rFeijoo/FPGA_PID/README.md

# Betta's House
Implementação em FPGA de um sistema de controle PID para controle da temperatura em aquários de pequeno porte, do tipo beteira.
