rFeijoo/FPGA_PID/PC2/2 - octave/Hardware_VS_Software - Integrative Simulation.png

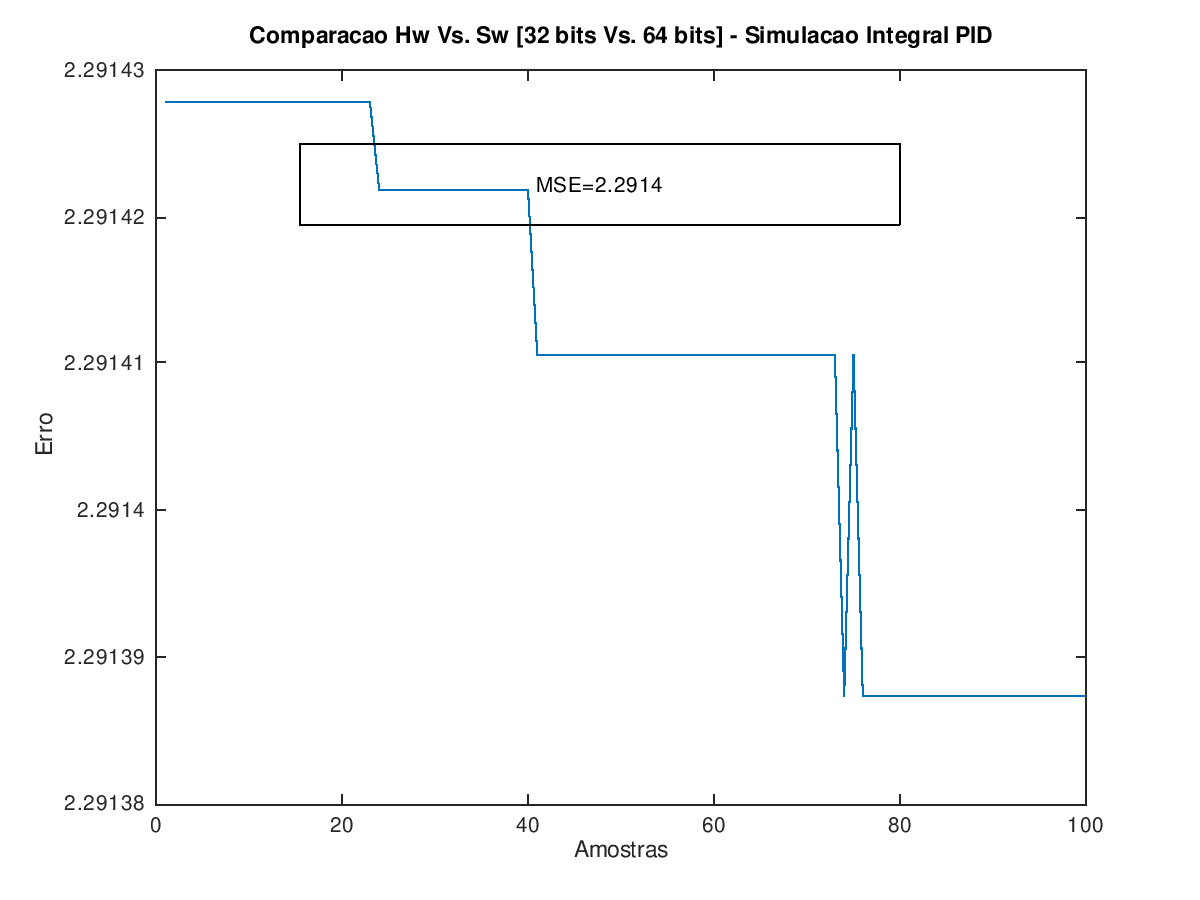
PC2/2 - octave/Hardware_VS_Software - Integrative Simulation.png
