rFeijoo/FPGA_PID/PC3/3 - Interface - Arduino X Basys3/1 - Esquemático RTL.png

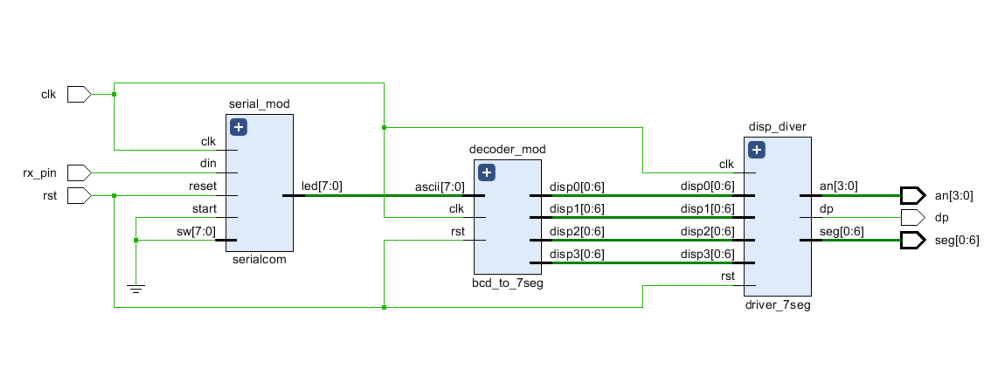
PC3/3 - Interface - Arduino X Basys3/1 - Esquemático RTL.png
