rFeijoo/FPGA_PID/PC3/3 - Interface - Arduino X Basys3/2 - Layout.png

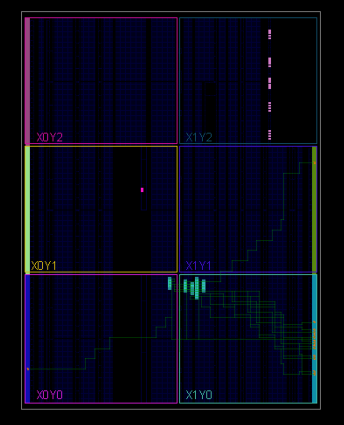
PC3/3 - Interface - Arduino X Basys3/2 - Layout.png
