rFeijoo/FPGA_PID/PC3/3 - Interface - Arduino X Basys3/3 - Consumo de Potência.png

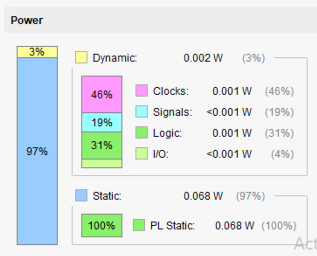
PC3/3 - Interface - Arduino X Basys3/3 - Consumo de Potência.png
