rFeijoo/FPGA_PID/PC3/3 - Interface - Arduino X Basys3/4 - Gráfico de Potência.png

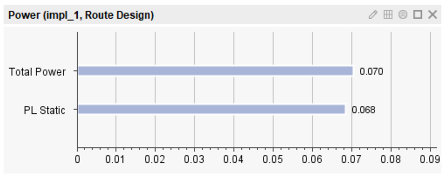
PC3/3 - Interface - Arduino X Basys3/4 - Gráfico de Potência.png
