rFeijoo/FPGA_PID/PC3/5 - Figuras/Figura 3.png

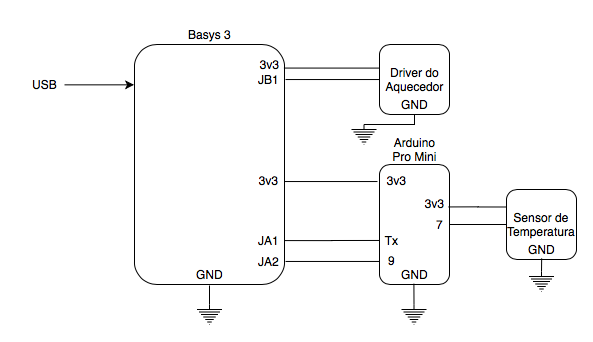
PC3/5 - Figuras/Figura 3.png
