rFeijoo/FPGA_PID/PC3/5 - Figuras/Figura 4.png

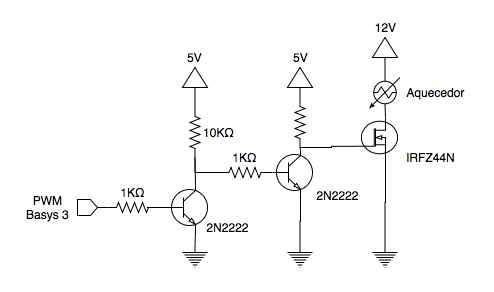
PC3/5 - Figuras/Figura 4.png
