rFeijoo/FPGA_PID/PC3/5 - Figuras/Figura 5.png

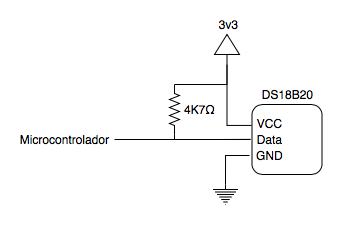
PC3/5 - Figuras/Figura 5.png
