rFeijoo/FPGA_PID/PC3/5 - Figuras/Figura 7.png

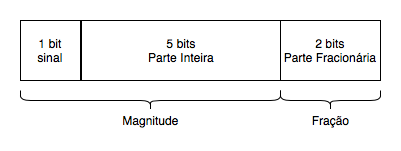
PC3/5 - Figuras/Figura 7.png
