rFeijoo/FPGA_PID/PC3/5 - Figuras/Figura 9.png

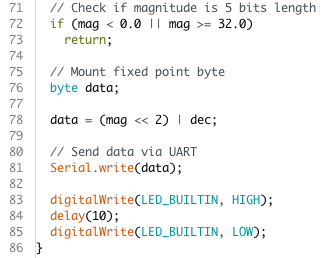
PC3/5 - Figuras/Figura 9.png
