rFeijoo/FPGA_PID/PC3/5 - Figuras/Figura 12.png

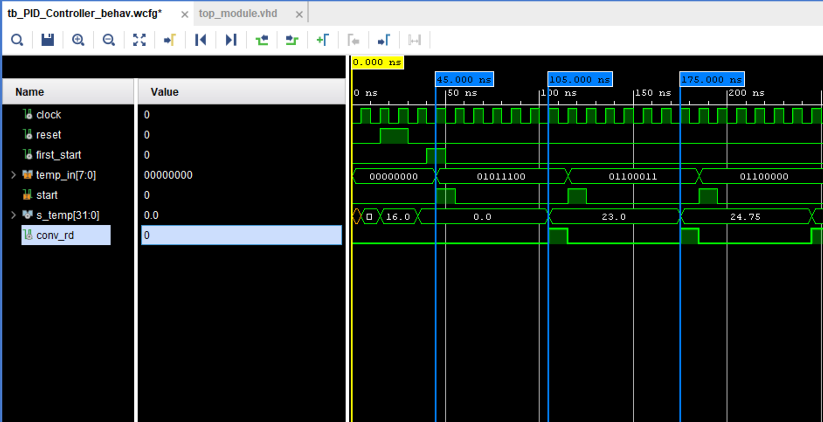
PC3/5 - Figuras/Figura 12.png
