rFeijoo/FPGA_PID/PC3/5 - Figuras/Figura 13.png

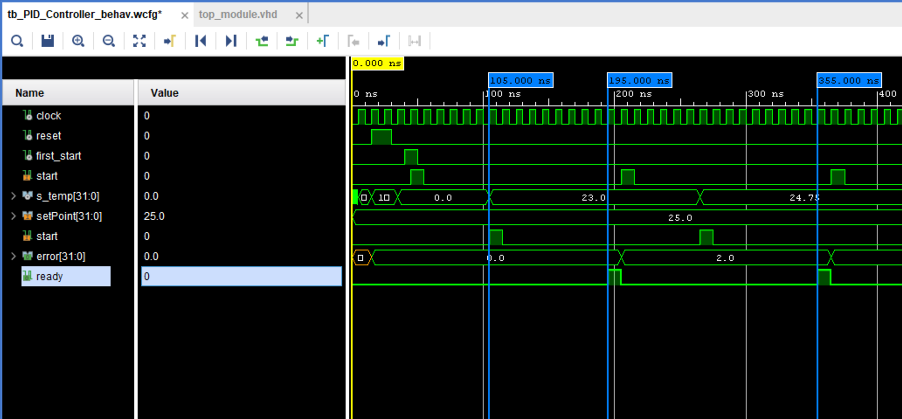
PC3/5 - Figuras/Figura 13.png
