rFeijoo/FPGA_PID/PC3/5 - Figuras/Figura 15.png

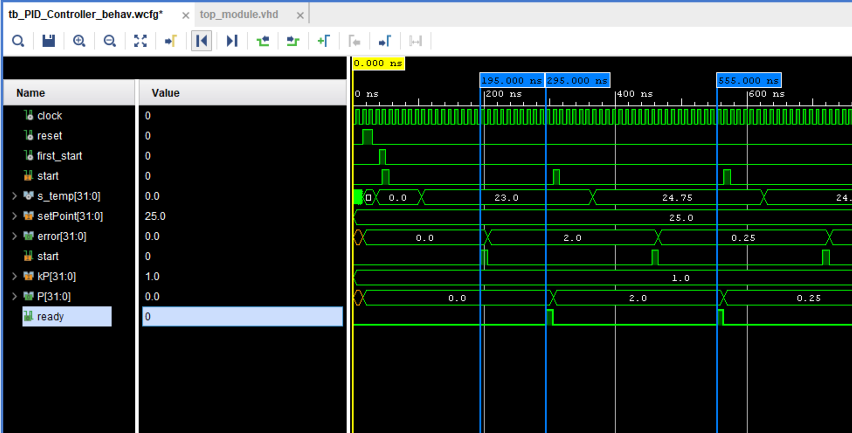
PC3/5 - Figuras/Figura 15.png
