rFeijoo/FPGA_PID/PC3/5 - Figuras/Figura 17.png

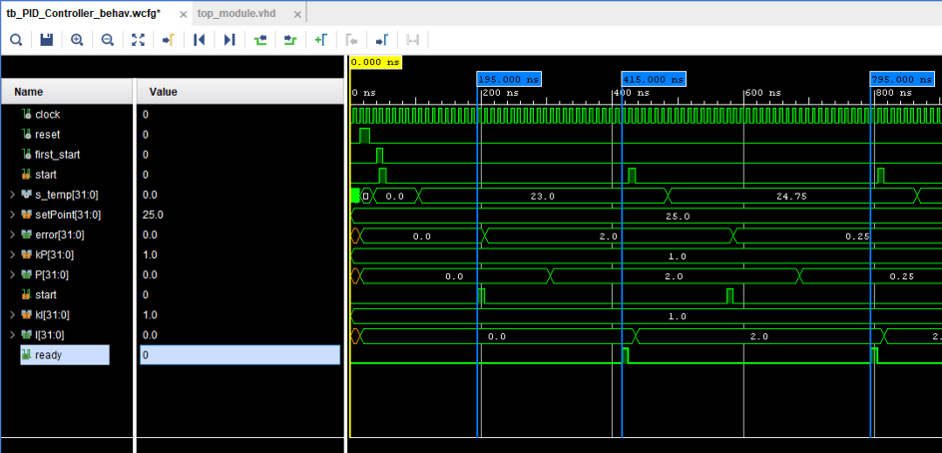
PC3/5 - Figuras/Figura 17.png
