rFeijoo/FPGA_PID/PC3/5 - Figuras/Figura 19.png

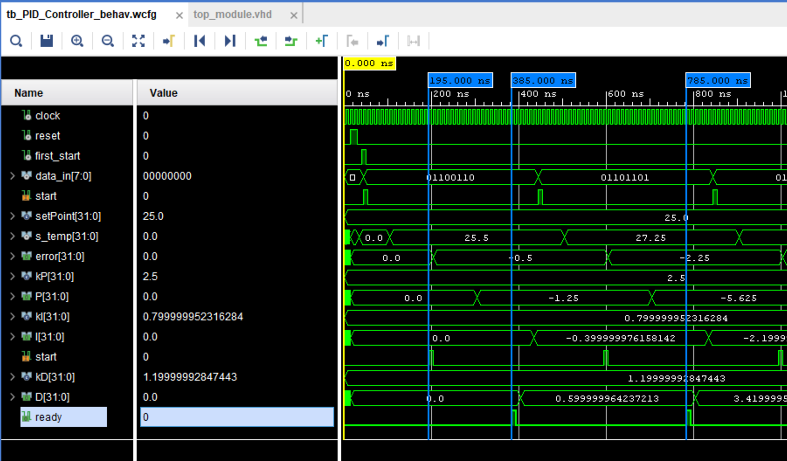
PC3/5 - Figuras/Figura 19.png
