rFeijoo/FPGA_PID/PC3/5 - Figuras/Figura 21.png

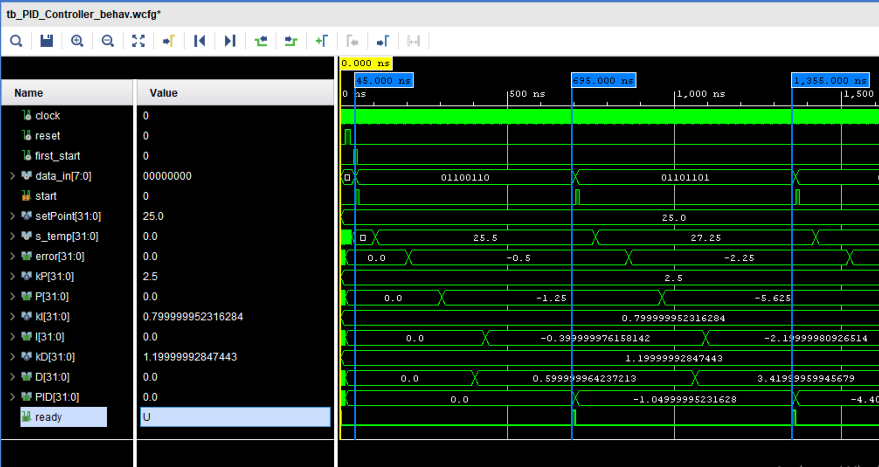
PC3/5 - Figuras/Figura 21.png
