rFeijoo/FPGA_PID/PC4/5 - Figuras/Figura 23.png

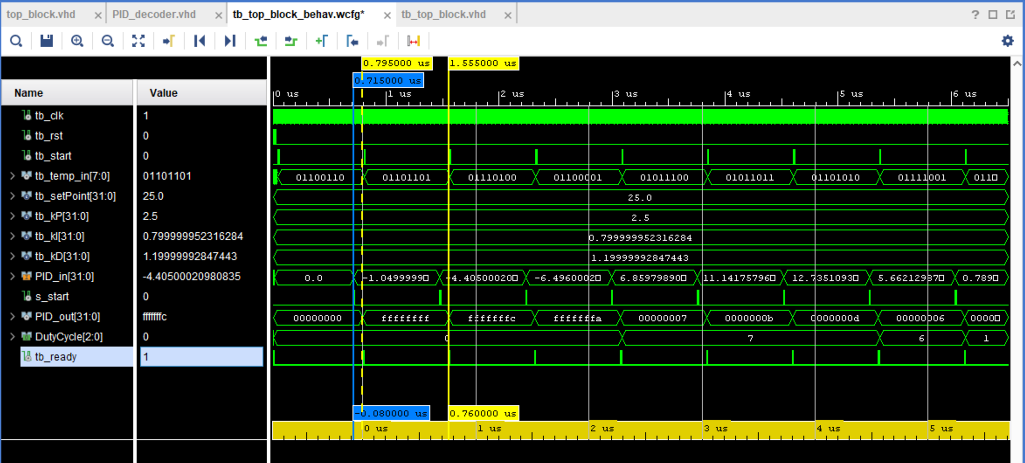
PC4/5 - Figuras/Figura 23.png
