rFeijoo/FPGA_PID/PC4/5 - Figuras/Figura 25.png

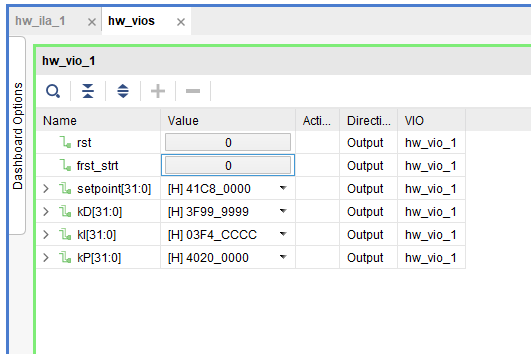
PC4/5 - Figuras/Figura 25.png
