rFeijoo/FPGA_PID/PC4/5 - Figuras/Figura 26.png

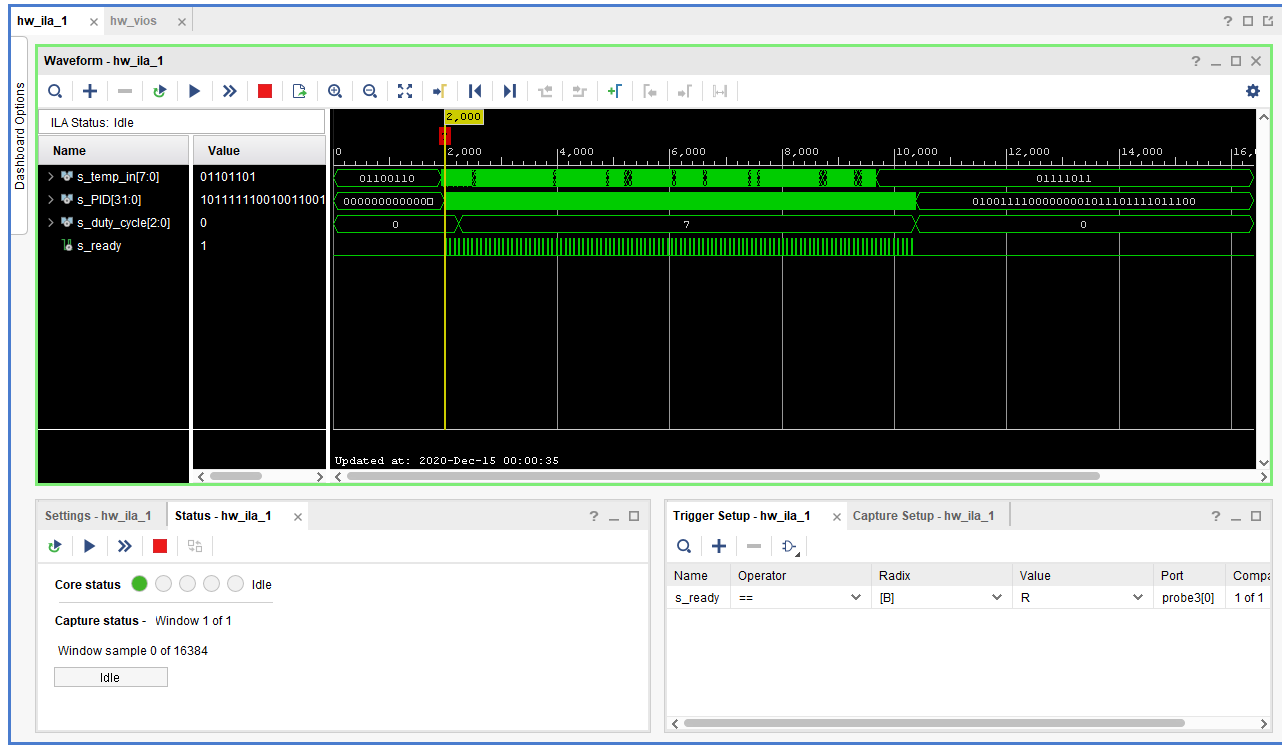
PC4/5 - Figuras/Figura 26.png
