rFeijoo/FPGA_PID/PC4/5 - Figuras/Figura 27.png

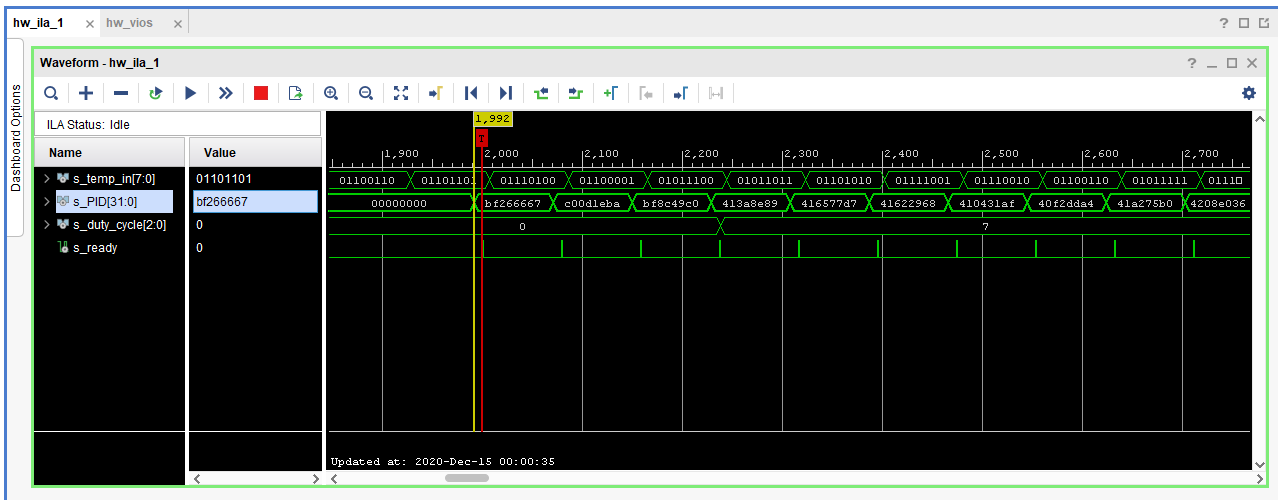
PC4/5 - Figuras/Figura 27.png
