rFeijoo/FPGA_PID/PC4/5 - Figuras/Figura 28.png

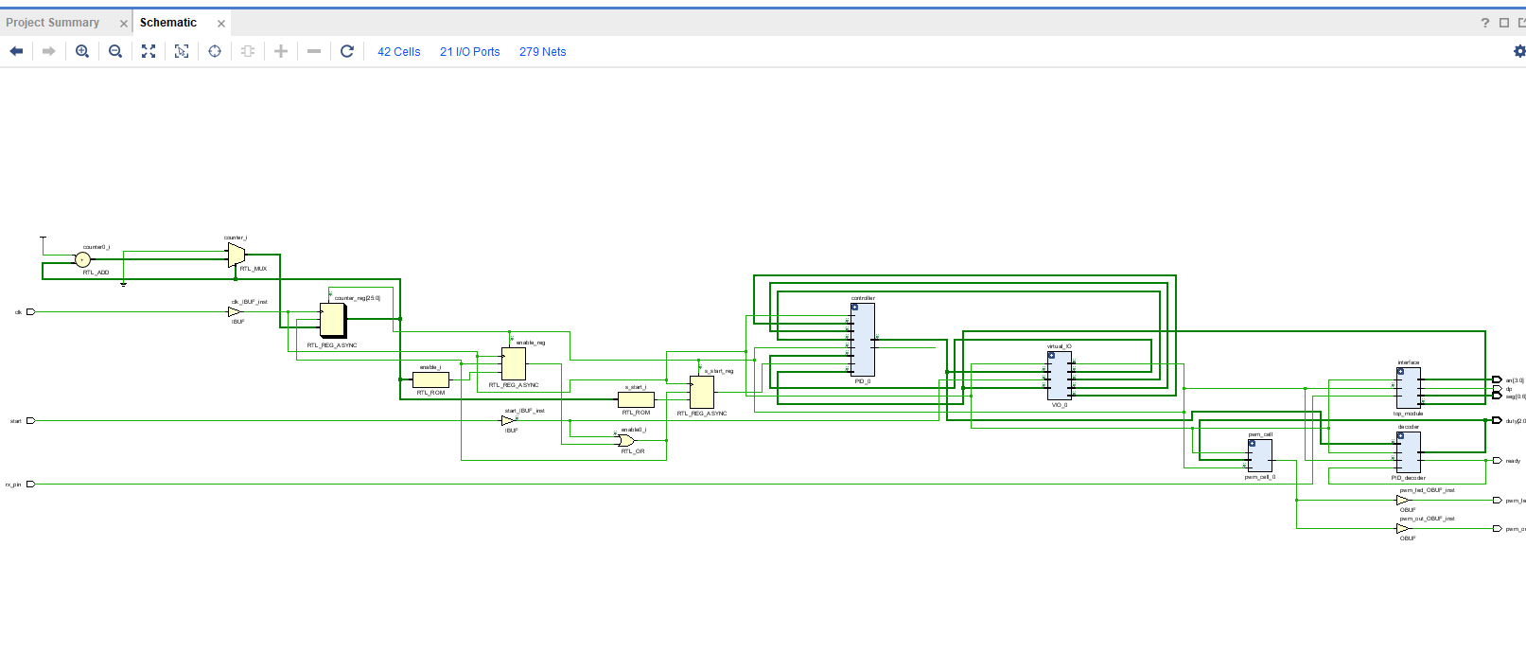
PC4/5 - Figuras/Figura 28.png
