rFeijoo/FPGA_PID/PC4/5 - Figuras/Figura 29.png

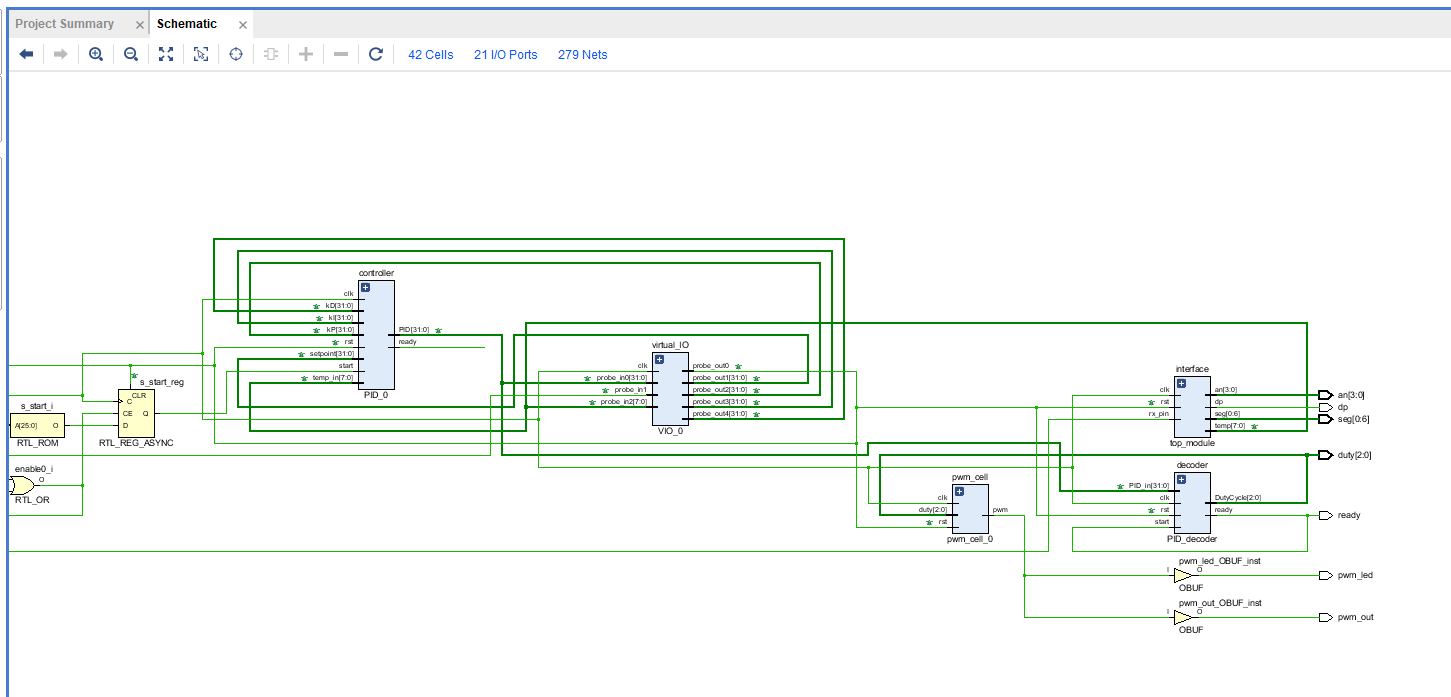
PC4/5 - Figuras/Figura 29.png
