rFeijoo/FPGA_PID/PC4/5 - Figuras/Figura 30.png

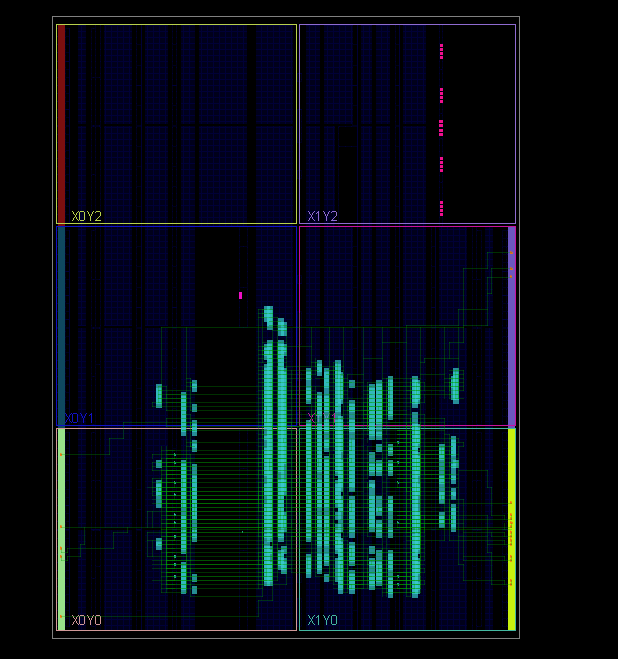
PC4/5 - Figuras/Figura 30.png
