rFeijoo/FPGA_PID/PC4/5 - Figuras/Figura 32.png

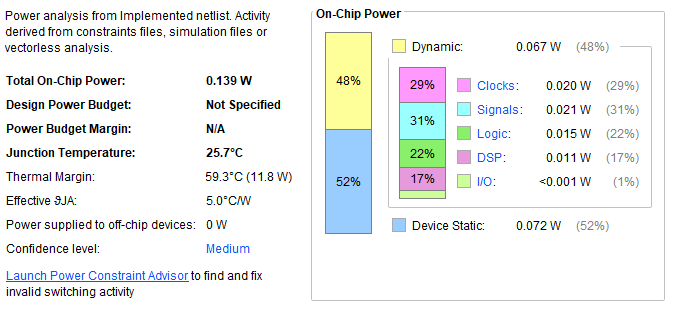
PC4/5 - Figuras/Figura 32.png
