rFeijoo/FPGA_PID/PC4/6 - vivado/Interface_Arduino_Basys3.srcs/sources_1/ip/PID_0/synth/PID_0.vhd

-- (c) Copyright 1995-2020 Xilinx, Inc. All rights reserved.
-- 
-- This file contains confidential and proprietary information
-- of Xilinx, Inc. and is protected under U.S. and
-- international copyright and other intellectual property
-- laws.
-- 
-- DISCLAIMER
-- This disclaimer is not a license and does not grant any
-- rights to the materials distributed herewith. Except as
-- otherwise provided in a valid license issued to you by
-- Xilinx, and to the maximum extent permitted by applicable
-- law: (1) THESE MATERIALS ARE MADE AVAILABLE "AS IS" AND
-- WITH ALL FAULTS, AND XILINX HEREBY DISCLAIMS ALL WARRANTIES
-- AND CONDITIONS, EXPRESS, IMPLIED, OR STATUTORY, INCLUDING
-- BUT NOT LIMITED TO WARRANTIES OF MERCHANTABILITY, NON-
-- INFRINGEMENT, OR FITNESS FOR ANY PARTICULAR PURPOSE; and
-- (2) Xilinx shall not be liable (whether in contract or tort,
-- including negligence, or under any other theory of
-- liability) for any loss or damage of any kind or nature
-- related to, arising under or in connection with these
-- materials, including for any direct, or any indirect,
-- special, incidental, or consequential loss or damage
-- (including loss of data, profits, goodwill, or any type of
-- loss or damage suffered as a result of any action brought
-- by a third party) even if such damage or loss was
-- reasonably foreseeable or Xilinx had been advised of the
-- possibility of the same.
-- 
-- CRITICAL APPLICATIONS
-- Xilinx products are not designed or intended to be fail-
-- safe, or for use in any application requiring fail-safe
-- performance, such as life-support or safety devices or
-- systems, Class III medical devices, nuclear facilities,
-- applications related to the deployment of airbags, or any
-- other applications that could lead to death, personal
-- injury, or severe property or environmental damage
-- (individually and collectively, "Critical
-- Applications"). Customer assumes the sole risk and
-- liability of any use of Xilinx products in Critical
-- Applications, subject only to applicable laws and
-- regulations governing limitations on product liability.
-- 
-- THIS COPYRIGHT NOTICE AND DISCLAIMER MUST BE RETAINED AS
-- PART OF THIS FILE AT ALL TIMES.
-- 
-- DO NOT MODIFY THIS FILE.

-- IP VLNV: xilinx.com:user:PID:1.0
-- IP Revision: 1

LIBRARY ieee;
USE ieee.std_logic_1164.ALL;
USE ieee.numeric_std.ALL;

ENTITY PID_0 IS
  PORT (
    clk : IN STD_LOGIC;
    rst : IN STD_LOGIC;
    start : IN STD_LOGIC;
    temp_in : IN STD_LOGIC_VECTOR(7 DOWNTO 0);
    setpoint : IN STD_LOGIC_VECTOR(31 DOWNTO 0);
    kP : IN STD_LOGIC_VECTOR(31 DOWNTO 0);
    kI : IN STD_LOGIC_VECTOR(31 DOWNTO 0);
    kD : IN STD_LOGIC_VECTOR(31 DOWNTO 0);
    PID : OUT STD_LOGIC_VECTOR(31 DOWNTO 0);
    ready : OUT STD_LOGIC
  );
END PID_0;

ARCHITECTURE PID_0_arch OF PID_0 IS
  ATTRIBUTE DowngradeIPIdentifiedWarnings : STRING;
  ATTRIBUTE DowngradeIPIdentifiedWarnings OF PID_0_arch: ARCHITECTURE IS "yes";
  COMPONENT top_module IS
    PORT (
      clk : IN STD_LOGIC;
      rst : IN STD_LOGIC;
      start : IN STD_LOGIC;
      temp_in : IN STD_LOGIC_VECTOR(7 DOWNTO 0);
      setpoint : IN STD_LOGIC_VECTOR(31 DOWNTO 0);
      kP : IN STD_LOGIC_VECTOR(31 DOWNTO 0);
      kI : IN STD_LOGIC_VECTOR(31 DOWNTO 0);
      kD : IN STD_LOGIC_VECTOR(31 DOWNTO 0);
      PID : OUT STD_LOGIC_VECTOR(31 DOWNTO 0);
      ready : OUT STD_LOGIC
    );
  END COMPONENT top_module;
  ATTRIBUTE X_CORE_INFO : STRING;
  ATTRIBUTE X_CORE_INFO OF PID_0_arch: ARCHITECTURE IS "top_module,Vivado 2018.3";
  ATTRIBUTE CHECK_LICENSE_TYPE : STRING;
  ATTRIBUTE CHECK_LICENSE_TYPE OF PID_0_arch : ARCHITECTURE IS "PID_0,top_module,{}";
  ATTRIBUTE CORE_GENERATION_INFO : STRING;
  ATTRIBUTE CORE_GENERATION_INFO OF PID_0_arch: ARCHITECTURE IS "PID_0,top_module,{x_ipProduct=Vivado 2018.3,x_ipVendor=xilinx.com,x_ipLibrary=user,x_ipName=PID,x_ipVersion=1.0,x_ipCoreRevision=1,x_ipLanguage=VHDL,x_ipSimLanguage=MIXED}";
  ATTRIBUTE IP_DEFINITION_SOURCE : STRING;
  ATTRIBUTE IP_DEFINITION_SOURCE OF PID_0_arch: ARCHITECTURE IS "package_project";
  ATTRIBUTE X_INTERFACE_INFO : STRING;
  ATTRIBUTE X_INTERFACE_PARAMETER : STRING;
  ATTRIBUTE X_INTERFACE_PARAMETER OF rst: SIGNAL IS "XIL_INTERFACENAME rst, POLARITY ACTIVE_LOW, INSERT_VIP 0";
  ATTRIBUTE X_INTERFACE_INFO OF rst: SIGNAL IS "xilinx.com:signal:reset:1.0 rst RST";
  ATTRIBUTE X_INTERFACE_PARAMETER OF clk: SIGNAL IS "XIL_INTERFACENAME clk, ASSOCIATED_RESET rst, FREQ_HZ 100000000, PHASE 0.000, INSERT_VIP 0";
  ATTRIBUTE X_INTERFACE_INFO OF clk: SIGNAL IS "xilinx.com:signal:clock:1.0 clk CLK";
BEGIN
  U0 : top_module
    PORT MAP (
      clk => clk,
      rst => rst,
      start => start,
      temp_in => temp_in,
      setpoint => setpoint,
      kP => kP,
      kI => kI,
      kD => kD,
      PID => PID,
      ready => ready
    );
END PID_0_arch;
