rFeijoo/FPGA_PID/PC4/6 - vivado/Interface_Arduino_Basys3.srcs/sources_1/ip/VIO_0/VIO_0_stub.vhdl

-- Copyright 1986-2018 Xilinx, Inc. All Rights Reserved.
-- --------------------------------------------------------------------------------
-- Tool Version: Vivado v.2018.3 (win64) Build 2405991 Thu Dec  6 23:38:27 MST 2018
-- Date        : Tue Dec 15 05:30:55 2020
-- Host        : RAFAELFEIJL2C3E running 64-bit major release  (build 9200)
-- Command     : write_vhdl -force -mode synth_stub
--               C:/Mac/Home/Documents/Windows/Vivado/Projects/Interface_Arduino_Basys3/Interface_Arduino_Basys3.srcs/sources_1/ip/VIO_0/VIO_0_stub.vhdl
-- Design      : VIO_0
-- Purpose     : Stub declaration of top-level module interface
-- Device      : xc7a35tcpg236-1
-- --------------------------------------------------------------------------------
library IEEE;
use IEEE.STD_LOGIC_1164.ALL;

entity VIO_0 is
  Port ( 
    clk : in STD_LOGIC;
    probe_in0 : in STD_LOGIC_VECTOR ( 31 downto 0 );
    probe_in1 : in STD_LOGIC_VECTOR ( 0 to 0 );
    probe_in2 : in STD_LOGIC_VECTOR ( 7 downto 0 );
    probe_out0 : out STD_LOGIC_VECTOR ( 0 to 0 );
    probe_out1 : out STD_LOGIC_VECTOR ( 31 downto 0 );
    probe_out2 : out STD_LOGIC_VECTOR ( 31 downto 0 );
    probe_out3 : out STD_LOGIC_VECTOR ( 31 downto 0 );
    probe_out4 : out STD_LOGIC_VECTOR ( 31 downto 0 )
  );

end VIO_0;

architecture stub of VIO_0 is
attribute syn_black_box : boolean;
attribute black_box_pad_pin : string;
attribute syn_black_box of stub : architecture is true;
attribute black_box_pad_pin of stub : architecture is "clk,probe_in0[31:0],probe_in1[0:0],probe_in2[7:0],probe_out0[0:0],probe_out1[31:0],probe_out2[31:0],probe_out3[31:0],probe_out4[31:0]";
attribute X_CORE_INFO : string;
attribute X_CORE_INFO of stub : architecture is "vio,Vivado 2018.3";
begin
end;
