rFeijoo/FPGA_PID/PC4/6 - vivado/Interface_Arduino_Basys3.srcs/sources_1/ip/pwm_cell_0/pwm_cell_0_sim_netlist.v

// Copyright 1986-2018 Xilinx, Inc. All Rights Reserved.
// --------------------------------------------------------------------------------
// Tool Version: Vivado v.2018.3 (win64) Build 2405991 Thu Dec  6 23:38:27 MST 2018
// Date        : Tue Dec 15 06:12:34 2020
// Host        : RAFAELFEIJL2C3E running 64-bit major release  (build 9200)
// Command     : write_verilog -force -mode funcsim
//               c:/Mac/Home/Documents/Windows/Vivado/Projects/Interface_Arduino_Basys3/Interface_Arduino_Basys3.srcs/sources_1/ip/pwm_cell_0/pwm_cell_0_sim_netlist.v
// Design      : pwm_cell_0
// Purpose     : This verilog netlist is a functional simulation representation of the design and should not be modified
//               or synthesized. This netlist cannot be used for SDF annotated simulation.
// Device      : xc7a35tcpg236-1
// --------------------------------------------------------------------------------
`timescale 1 ps / 1 ps

(* CHECK_LICENSE_TYPE = "pwm_cell_0,pwm_cell,{}" *) (* downgradeipidentifiedwarnings = "yes" *) (* ip_definition_source = "package_project" *) 
(* x_core_info = "pwm_cell,Vivado 2018.3" *) 
(* NotValidForBitStream *)
module pwm_cell_0
   (clk,
    rst,
    duty,
    pwm);
  (* x_interface_info = "xilinx.com:signal:clock:1.0 clk CLK" *) (* x_interface_parameter = "XIL_INTERFACENAME clk, ASSOCIATED_RESET rst, FREQ_HZ 100000000, PHASE 0.000, INSERT_VIP 0" *) input clk;
  (* x_interface_info = "xilinx.com:signal:reset:1.0 rst RST" *) (* x_interface_parameter = "XIL_INTERFACENAME rst, POLARITY ACTIVE_LOW, INSERT_VIP 0" *) input rst;
  input [2:0]duty;
  output pwm;

  wire clk;
  wire [2:0]duty;
  wire pwm;
  wire rst;

  pwm_cell_0_pwm_cell U0
       (.clk(clk),
        .duty(duty),
        .pwm(pwm),
        .rst(rst));
endmodule

(* ORIG_REF_NAME = "pwm_cell" *) 
module pwm_cell_0_pwm_cell
   (pwm,
    clk,
    duty,
    rst);
  output pwm;
  input clk;
  input [2:0]duty;
  input rst;

  wire clk;
  wire [31:1]data0;
  wire [2:0]duty;
  wire pwm;
  wire rst;
  wire [31:0]s_clk_counter;
  wire [31:0]s_clk_counter_0;
  wire \s_clk_counter_reg[12]_i_2_n_0 ;
  wire \s_clk_counter_reg[12]_i_2_n_1 ;
  wire \s_clk_counter_reg[12]_i_2_n_2 ;
  wire \s_clk_counter_reg[12]_i_2_n_3 ;
  wire \s_clk_counter_reg[16]_i_2_n_0 ;
  wire \s_clk_counter_reg[16]_i_2_n_1 ;
  wire \s_clk_counter_reg[16]_i_2_n_2 ;
  wire \s_clk_counter_reg[16]_i_2_n_3 ;
  wire \s_clk_counter_reg[20]_i_2_n_0 ;
  wire \s_clk_counter_reg[20]_i_2_n_1 ;
  wire \s_clk_counter_reg[20]_i_2_n_2 ;
  wire \s_clk_counter_reg[20]_i_2_n_3 ;
  wire \s_clk_counter_reg[24]_i_2_n_0 ;
  wire \s_clk_counter_reg[24]_i_2_n_1 ;
  wire \s_clk_counter_reg[24]_i_2_n_2 ;
  wire \s_clk_counter_reg[24]_i_2_n_3 ;
  wire \s_clk_counter_reg[28]_i_2_n_0 ;
  wire \s_clk_counter_reg[28]_i_2_n_1 ;
  wire \s_clk_counter_reg[28]_i_2_n_2 ;
  wire \s_clk_counter_reg[28]_i_2_n_3 ;
  wire \s_clk_counter_reg[31]_i_2_n_2 ;
  wire \s_clk_counter_reg[31]_i_2_n_3 ;
  wire \s_clk_counter_reg[4]_i_2_n_0 ;
  wire \s_clk_counter_reg[4]_i_2_n_1 ;
  wire \s_clk_counter_reg[4]_i_2_n_2 ;
  wire \s_clk_counter_reg[4]_i_2_n_3 ;
  wire \s_clk_counter_reg[8]_i_2_n_0 ;
  wire \s_clk_counter_reg[8]_i_2_n_1 ;
  wire \s_clk_counter_reg[8]_i_2_n_2 ;
  wire \s_clk_counter_reg[8]_i_2_n_3 ;
  wire s_pwm0_carry__0_n_0;
  wire s_pwm0_carry__0_n_1;
  wire s_pwm0_carry__0_n_2;
  wire s_pwm0_carry__0_n_3;
  wire s_pwm0_carry__1_n_1;
  wire s_pwm0_carry__1_n_2;
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
  LUT6 #(
    .INIT(64'h2010020401024001)) 
    s_pwm0_carry_i_4
       (.I0(s_clk_counter[13]),
        .I1(s_clk_counter[14]),
        .I2(s_clk_counter[12]),
        .I3(duty[2]),
        .I4(duty[1]),
        .I5(duty[0]),
        .O(s_pwm0_carry_i_4_n_0));
  LUT6 #(
    .INIT(64'h2400201000820201)) 
    s_pwm0_carry_i_4__0
       (.I0(s_clk_counter[2]),
        .I1(s_clk_counter[1]),
        .I2(duty[2]),
        .I3(duty[0]),
        .I4(duty[1]),
        .I5(s_clk_counter[0]),
        .O(s_pwm0_carry_i_4__0_n_0));
  (* SOFT_HLUTNM = "soft_lutpair0" *) 
  LUT3 #(
    .INIT(8'h73)) 
    s_pwm_i_1
       (.I0(s_pwm0_carry__1_n_1),
        .I1(s_pwm_i_3_n_0),
        .I2(pwm),
        .O(s_pwm_i_1_n_0));
  LUT4 #(
    .INIT(16'hFF01)) 
    s_pwm_i_2
       (.I0(duty[2]),
        .I1(duty[0]),
        .I2(duty[1]),
        .I3(rst),
        .O(s_pwm_i_2_n_0));
  LUT6 #(
    .INIT(64'hFFFFFFFFFFFFFFFE)) 
    s_pwm_i_3
       (.I0(s_pwm_i_4_n_0),
        .I1(s_pwm_i_5_n_0),
        .I2(s_pwm_i_6_n_0),
        .I3(s_pwm_i_7_n_0),
        .I4(s_pwm_i_8_n_0),
        .I5(s_pwm_i_9_n_0),
        .O(s_pwm_i_3_n_0));
  LUT5 #(
    .INIT(32'hFFFFFFFE)) 
    s_pwm_i_4
       (.I0(s_clk_counter[27]),
        .I1(s_clk_counter[28]),
        .I2(s_clk_counter[29]),
        .I3(s_clk_counter[31]),
        .I4(s_clk_counter[30]),
        .O(s_pwm_i_4_n_0));
  (* SOFT_HLUTNM = "soft_lutpair1" *) 
  LUT3 #(
    .INIT(8'hDF)) 
    s_pwm_i_5
       (.I0(s_clk_counter[2]),
        .I1(s_clk_counter[1]),
        .I2(s_clk_counter[0]),
        .O(s_pwm_i_5_n_0));
  LUT6 #(
    .INIT(64'hFFFFFDFFFFFFFFFF)) 
    s_pwm_i_6
       (.I0(s_clk_counter[15]),
        .I1(s_clk_counter[16]),
        .I2(s_clk_counter[17]),
        .I3(s_clk_counter[19]),
        .I4(s_clk_counter[20]),
        .I5(s_clk_counter[18]),
        .O(s_pwm_i_6_n_0));
  LUT6 #(
    .INIT(64'hFFFFFFFFFFFFFFFE)) 
    s_pwm_i_7
       (.I0(s_clk_counter[21]),
        .I1(s_clk_counter[22]),
        .I2(s_clk_counter[23]),
        .I3(s_clk_counter[24]),
        .I4(s_clk_counter[25]),
        .I5(s_clk_counter[26]),
        .O(s_pwm_i_7_n_0));
  LUT6 #(
    .INIT(64'hFFFFDFFFFFFFFFFF)) 
    s_pwm_i_8
       (.I0(s_clk_counter[9]),
        .I1(s_clk_counter[11]),
        .I2(s_clk_counter[10]),
        .I3(s_clk_counter[12]),
        .I4(s_clk_counter[14]),
        .I5(s_clk_counter[13]),
        .O(s_pwm_i_8_n_0));
  LUT6 #(
    .INIT(64'hFFFFFFDFFFFFFFFF)) 
    s_pwm_i_9
       (.I0(s_clk_counter[4]),
        .I1(s_clk_counter[3]),
        .I2(s_clk_counter[5]),
        .I3(s_clk_counter[7]),
        .I4(s_clk_counter[6]),
        .I5(s_clk_counter[8]),
        .O(s_pwm_i_9_n_0));
  FDCE #(
    .INIT(1'b0)) 
    s_pwm_reg
       (.C(clk),
        .CE(1'b1),
        .CLR(s_pwm_i_2_n_0),
        .D(s_pwm_i_1_n_0),
        .Q(pwm));
endmodule
`ifndef GLBL
`define GLBL
`timescale  1 ps / 1 ps

module glbl ();

    parameter ROC_WIDTH = 100000;
    parameter TOC_WIDTH = 0;

//--------   STARTUP Globals --------------
    wire GSR;
    wire GTS;
    wire GWE;
    wire PRLD;
    tri1 p_up_tmp;
    tri (weak1, strong0) PLL_LOCKG = p_up_tmp;

    wire PROGB_GLBL;
    wire CCLKO_GLBL;
    wire FCSBO_GLBL;
    wire [3:0] DO_GLBL;
    wire [3:0] DI_GLBL;
   
    reg GSR_int;
    reg GTS_int;
    reg PRLD_int;

//--------   JTAG Globals --------------
    wire JTAG_TDO_GLBL;
    wire JTAG_TCK_GLBL;
    wire JTAG_TDI_GLBL;
    wire JTAG_TMS_GLBL;
    wire JTAG_TRST_GLBL;

    reg JTAG_CAPTURE_GLBL;
    reg JTAG_RESET_GLBL;
    reg JTAG_SHIFT_GLBL;
    reg JTAG_UPDATE_GLBL;
    reg JTAG_RUNTEST_GLBL;

    reg JTAG_SEL1_GLBL = 0;
    reg JTAG_SEL2_GLBL = 0 ;
    reg JTAG_SEL3_GLBL = 0;
    reg JTAG_SEL4_GLBL = 0;

    reg JTAG_USER_TDO1_GLBL = 1'bz;
    reg JTAG_USER_TDO2_GLBL = 1'bz;
    reg JTAG_USER_TDO3_GLBL = 1'bz;
    reg JTAG_USER_TDO4_GLBL = 1'bz;

    assign (strong1, weak0) GSR = GSR_int;
    assign (strong1, weak0) GTS = GTS_int;
    assign (weak1, weak0) PRLD = PRLD_int;

    initial begin
	GSR_int = 1'b1;
	PRLD_int = 1'b1;
	#(ROC_WIDTH)
	GSR_int = 1'b0;
	PRLD_int = 1'b0;
    end

    initial begin
	GTS_int = 1'b1;
	#(TOC_WIDTH)
	GTS_int = 1'b0;
    end

endmodule
`endif
