rFeijoo/FPGA_PID/PC4/6 - vivado/Interface_Arduino_Basys3.srcs/sources_1/ip/pwm_cell_0/pwm_cell_0_sim_netlist.vhdl

-- Copyright 1986-2018 Xilinx, Inc. All Rights Reserved.
-- --------------------------------------------------------------------------------
-- Tool Version: Vivado v.2018.3 (win64) Build 2405991 Thu Dec  6 23:38:27 MST 2018
-- Date        : Tue Dec 15 06:12:34 2020
-- Host        : RAFAELFEIJL2C3E running 64-bit major release  (build 9200)
-- Command     : write_vhdl -force -mode funcsim
--               c:/Mac/Home/Documents/Windows/Vivado/Projects/Interface_Arduino_Basys3/Interface_Arduino_Basys3.srcs/sources_1/ip/pwm_cell_0/pwm_cell_0_sim_netlist.vhdl
-- Design      : pwm_cell_0
-- Purpose     : This VHDL netlist is a functional simulation representation of the design and should not be modified or
--               synthesized. This netlist cannot be used for SDF annotated simulation.
-- Device      : xc7a35tcpg236-1
-- --------------------------------------------------------------------------------
library IEEE;
use IEEE.STD_LOGIC_1164.ALL;
library UNISIM;
use UNISIM.VCOMPONENTS.ALL;
entity pwm_cell_0_pwm_cell is
  port (
    pwm : out STD_LOGIC;
    clk : in STD_LOGIC;
    duty : in STD_LOGIC_VECTOR ( 2 downto 0 );
    rst : in STD_LOGIC
  );
  attribute ORIG_REF_NAME : string;
  attribute ORIG_REF_NAME of pwm_cell_0_pwm_cell : entity is "pwm_cell";
end pwm_cell_0_pwm_cell;

architecture STRUCTURE of pwm_cell_0_pwm_cell is
  signal data0 : STD_LOGIC_VECTOR ( 31 downto 1 );
  signal \^pwm\ : STD_LOGIC;
  signal s_clk_counter : STD_LOGIC_VECTOR ( 31 downto 0 );
  signal s_clk_counter_0 : STD_LOGIC_VECTOR ( 31 downto 0 );
  signal \s_clk_counter_reg[12]_i_2_n_0\ : STD_LOGIC;
  signal \s_clk_counter_reg[12]_i_2_n_1\ : STD_LOGIC;
  signal \s_clk_counter_reg[12]_i_2_n_2\ : STD_LOGIC;
  signal \s_clk_counter_reg[12]_i_2_n_3\ : STD_LOGIC;
  signal \s_clk_counter_reg[16]_i_2_n_0\ : STD_LOGIC;
  signal \s_clk_counter_reg[16]_i_2_n_1\ : STD_LOGIC;
  signal \s_clk_counter_reg[16]_i_2_n_2\ : STD_LOGIC;
  signal \s_clk_counter_reg[16]_i_2_n_3\ : STD_LOGIC;
  signal \s_clk_counter_reg[20]_i_2_n_0\ : STD_LOGIC;
  signal \s_clk_counter_reg[20]_i_2_n_1\ : STD_LOGIC;
  signal \s_clk_counter_reg[20]_i_2_n_2\ : STD_LOGIC;
  signal \s_clk_counter_reg[20]_i_2_n_3\ : STD_LOGIC;
  signal \s_clk_counter_reg[24]_i_2_n_0\ : STD_LOGIC;
  signal \s_clk_counter_reg[24]_i_2_n_1\ : STD_LOGIC;
  signal \s_clk_counter_reg[24]_i_2_n_2\ : STD_LOGIC;
  signal \s_clk_counter_reg[24]_i_2_n_3\ : STD_LOGIC;
  signal \s_clk_counter_reg[28]_i_2_n_0\ : STD_LOGIC;
  signal \s_clk_counter_reg[28]_i_2_n_1\ : STD_LOGIC;
  signal \s_clk_counter_reg[28]_i_2_n_2\ : STD_LOGIC;
  signal \s_clk_counter_reg[28]_i_2_n_3\ : STD_LOGIC;
  signal \s_clk_counter_reg[31]_i_2_n_2\ : STD_LOGIC;
  signal \s_clk_counter_reg[31]_i_2_n_3\ : STD_LOGIC;
  signal \s_clk_counter_reg[4]_i_2_n_0\ : STD_LOGIC;
  signal \s_clk_counter_reg[4]_i_2_n_1\ : STD_LOGIC;
  signal \s_clk_counter_reg[4]_i_2_n_2\ : STD_LOGIC;
  signal \s_clk_counter_reg[4]_i_2_n_3\ : STD_LOGIC;
  signal \s_clk_counter_reg[8]_i_2_n_0\ : STD_LOGIC;
  signal \s_clk_counter_reg[8]_i_2_n_1\ : STD_LOGIC;
  signal \s_clk_counter_reg[8]_i_2_n_2\ : STD_LOGIC;
  signal \s_clk_counter_reg[8]_i_2_n_3\ : STD_LOGIC;
  signal \s_pwm0_carry__0_n_0\ : STD_LOGIC;
  signal \s_pwm0_carry__0_n_1\ : STD_LOGIC;
  signal \s_pwm0_carry__0_n_2\ : STD_LOGIC;
  signal \s_pwm0_carry__0_n_3\ : STD_LOGIC;
  signal \s_pwm0_carry__1_n_1\ : STD_LOGIC;
  signal \s_pwm0_carry__1_n_2\ : STD_LOGIC;
  signal \s_pwm0_carry__1_n_3\ : STD_LOGIC;
  signal \s_pwm0_carry_i_1__0_n_0\ : STD_LOGIC;
  signal \s_pwm0_carry_i_1__1_n_0\ : STD_LOGIC;
  signal s_pwm0_carry_i_1_n_0 : STD_LOGIC;
  signal \s_pwm0_carry_i_2__0_n_0\ : STD_LOGIC;
  signal \s_pwm0_carry_i_2__1_n_0\ : STD_LOGIC;
  signal s_pwm0_carry_i_2_n_0 : STD_LOGIC;
  signal \s_pwm0_carry_i_3__0_n_0\ : STD_LOGIC;
  signal \s_pwm0_carry_i_3__1_n_0\ : STD_LOGIC;
  signal s_pwm0_carry_i_3_n_0 : STD_LOGIC;
  signal \s_pwm0_carry_i_4__0_n_0\ : STD_LOGIC;
  signal s_pwm0_carry_i_4_n_0 : STD_LOGIC;
  signal s_pwm0_carry_n_0 : STD_LOGIC;
  signal s_pwm0_carry_n_1 : STD_LOGIC;
  signal s_pwm0_carry_n_2 : STD_LOGIC;
  signal s_pwm0_carry_n_3 : STD_LOGIC;
  signal s_pwm_i_1_n_0 : STD_LOGIC;
  signal s_pwm_i_2_n_0 : STD_LOGIC;
  signal s_pwm_i_3_n_0 : STD_LOGIC;
  signal s_pwm_i_4_n_0 : STD_LOGIC;
  signal s_pwm_i_5_n_0 : STD_LOGIC;
  signal s_pwm_i_6_n_0 : STD_LOGIC;
  signal s_pwm_i_7_n_0 : STD_LOGIC;
  signal s_pwm_i_8_n_0 : STD_LOGIC;
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
    generic map(
      INIT => '1'
    )
        port map (
      C => clk,
      CE => '1',
      D => s_clk_counter_0(5),
      PRE => s_pwm_i_2_n_0,
      Q => s_clk_counter(5)
    );
\s_clk_counter_reg[6]\: unisim.vcomponents.FDCE
    generic map(
      INIT => '0'
    )
        port map (
      C => clk,
      CE => '1',
      CLR => s_pwm_i_2_n_0,
      D => s_clk_counter_0(6),
      Q => s_clk_counter(6)
    );
\s_clk_counter_reg[7]\: unisim.vcomponents.FDCE
    generic map(
      INIT => '0'
    )
        port map (
      C => clk,
      CE => '1',
      CLR => s_pwm_i_2_n_0,
      D => s_clk_counter_0(7),
      Q => s_clk_counter(7)
    );
\s_clk_counter_reg[8]\: unisim.vcomponents.FDPE
    generic map(
      INIT => '1'
    )
        port map (
      C => clk,
      CE => '1',
      D => s_clk_counter_0(8),
      PRE => s_pwm_i_2_n_0,
      Q => s_clk_counter(8)
    );
\s_clk_counter_reg[8]_i_2\: unisim.vcomponents.CARRY4
     port map (
      CI => \s_clk_counter_reg[4]_i_2_n_0\,
      CO(3) => \s_clk_counter_reg[8]_i_2_n_0\,
      CO(2) => \s_clk_counter_reg[8]_i_2_n_1\,
      CO(1) => \s_clk_counter_reg[8]_i_2_n_2\,
      CO(0) => \s_clk_counter_reg[8]_i_2_n_3\,
      CYINIT => '0',
      DI(3 downto 0) => B"0000",
      O(3 downto 0) => data0(8 downto 5),
      S(3 downto 0) => s_clk_counter(8 downto 5)
    );
\s_clk_counter_reg[9]\: unisim.vcomponents.FDPE
    generic map(
      INIT => '1'
    )
        port map (
      C => clk,
      CE => '1',
      D => s_clk_counter_0(9),
      PRE => s_pwm_i_2_n_0,
      Q => s_clk_counter(9)
    );
s_pwm0_carry: unisim.vcomponents.CARRY4
     port map (
      CI => '0',
      CO(3) => s_pwm0_carry_n_0,
      CO(2) => s_pwm0_carry_n_1,
      CO(1) => s_pwm0_carry_n_2,
      CO(0) => s_pwm0_carry_n_3,
      CYINIT => '1',
      DI(3 downto 0) => B"0000",
      O(3 downto 0) => NLW_s_pwm0_carry_O_UNCONNECTED(3 downto 0),
      S(3) => s_pwm0_carry_i_1_n_0,
      S(2) => s_pwm0_carry_i_2_n_0,
      S(1) => \s_pwm0_carry_i_3__0_n_0\,
      S(0) => \s_pwm0_carry_i_4__0_n_0\
    );
\s_pwm0_carry__0\: unisim.vcomponents.CARRY4
     port map (
      CI => s_pwm0_carry_n_0,
      CO(3) => \s_pwm0_carry__0_n_0\,
      CO(2) => \s_pwm0_carry__0_n_1\,
      CO(1) => \s_pwm0_carry__0_n_2\,
      CO(0) => \s_pwm0_carry__0_n_3\,
      CYINIT => '0',
      DI(3 downto 0) => B"0000",
      O(3 downto 0) => \NLW_s_pwm0_carry__0_O_UNCONNECTED\(3 downto 0),
      S(3) => \s_pwm0_carry_i_1__0_n_0\,
      S(2) => \s_pwm0_carry_i_2__0_n_0\,
      S(1) => s_pwm0_carry_i_3_n_0,
      S(0) => s_pwm0_carry_i_4_n_0
    );
\s_pwm0_carry__1\: unisim.vcomponents.CARRY4
     port map (
      CI => \s_pwm0_carry__0_n_0\,
      CO(3) => \NLW_s_pwm0_carry__1_CO_UNCONNECTED\(3),
      CO(2) => \s_pwm0_carry__1_n_1\,
      CO(1) => \s_pwm0_carry__1_n_2\,
      CO(0) => \s_pwm0_carry__1_n_3\,
      CYINIT => '0',
      DI(3 downto 0) => B"0000",
      O(3 downto 0) => \NLW_s_pwm0_carry__1_O_UNCONNECTED\(3 downto 0),
      S(3) => '0',
      S(2) => \s_pwm0_carry_i_1__1_n_0\,
      S(1) => \s_pwm0_carry_i_2__1_n_0\,
      S(0) => \s_pwm0_carry_i_3__1_n_0\
    );
s_pwm0_carry_i_1: unisim.vcomponents.LUT6
    generic map(
      INIT => X"0C00006000062001"
    )
        port map (
      I0 => duty(2),
      I1 => s_clk_counter(10),
      I2 => s_clk_counter(11),
      I3 => s_clk_counter(9),
      I4 => duty(0),
      I5 => duty(1),
      O => s_pwm0_carry_i_1_n_0
    );
\s_pwm0_carry_i_1__0\: unisim.vcomponents.LUT3
    generic map(
      INIT => X"01"
    )
        port map (
      I0 => s_clk_counter(21),
      I1 => s_clk_counter(22),
      I2 => s_clk_counter(23),
      O => \s_pwm0_carry_i_1__0_n_0\
    );
\s_pwm0_carry_i_1__1\: unisim.vcomponents.LUT2
    generic map(
      INIT => X"1"
    )
        port map (
      I0 => s_clk_counter(31),
      I1 => s_clk_counter(30),
      O => \s_pwm0_carry_i_1__1_n_0\
    );
s_pwm0_carry_i_2: unisim.vcomponents.LUT6
    generic map(
      INIT => X"0404084001408001"
    )
        port map (
      I0 => s_clk_counter(6),
      I1 => s_clk_counter(8),
      I2 => s_clk_counter(7),
      I3 => duty(1),
      I4 => duty(0),
      I5 => duty(2),
      O => s_pwm0_carry_i_2_n_0
    );
\s_pwm0_carry_i_2__0\: unisim.vcomponents.LUT6
    generic map(
      INIT => X"2002020110010201"
    )
        port map (
      I0 => s_clk_counter(18),
      I1 => s_clk_counter(20),
      I2 => s_clk_counter(19),
      I3 => duty(2),
      I4 => duty(1),
      I5 => duty(0),
      O => \s_pwm0_carry_i_2__0_n_0\
    );
\s_pwm0_carry_i_2__1\: unisim.vcomponents.LUT3
    generic map(
      INIT => X"01"
    )
        port map (
      I0 => s_clk_counter(27),
      I1 => s_clk_counter(28),
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
    )
        port map (
      C => clk,
      CE => '1',
      CLR => s_pwm_i_2_n_0,
      D => s_pwm_i_1_n_0,
      Q => \^pwm\
    );
end STRUCTURE;
library IEEE;
use IEEE.STD_LOGIC_1164.ALL;
library UNISIM;
use UNISIM.VCOMPONENTS.ALL;
entity pwm_cell_0 is
  port (
    clk : in STD_LOGIC;
    rst : in STD_LOGIC;
    duty : in STD_LOGIC_VECTOR ( 2 downto 0 );
    pwm : out STD_LOGIC
  );
  attribute NotValidForBitStream : boolean;
  attribute NotValidForBitStream of pwm_cell_0 : entity is true;
  attribute CHECK_LICENSE_TYPE : string;
  attribute CHECK_LICENSE_TYPE of pwm_cell_0 : entity is "pwm_cell_0,pwm_cell,{}";
  attribute downgradeipidentifiedwarnings : string;
  attribute downgradeipidentifiedwarnings of pwm_cell_0 : entity is "yes";
  attribute ip_definition_source : string;
  attribute ip_definition_source of pwm_cell_0 : entity is "package_project";
  attribute x_core_info : string;
  attribute x_core_info of pwm_cell_0 : entity is "pwm_cell,Vivado 2018.3";
end pwm_cell_0;

architecture STRUCTURE of pwm_cell_0 is
  attribute x_interface_info : string;
  attribute x_interface_info of clk : signal is "xilinx.com:signal:clock:1.0 clk CLK";
  attribute x_interface_parameter : string;
  attribute x_interface_parameter of clk : signal is "XIL_INTERFACENAME clk, ASSOCIATED_RESET rst, FREQ_HZ 100000000, PHASE 0.000, INSERT_VIP 0";
  attribute x_interface_info of rst : signal is "xilinx.com:signal:reset:1.0 rst RST";
  attribute x_interface_parameter of rst : signal is "XIL_INTERFACENAME rst, POLARITY ACTIVE_LOW, INSERT_VIP 0";
begin
U0: entity work.pwm_cell_0_pwm_cell
     port map (
      clk => clk,
      duty(2 downto 0) => duty(2 downto 0),
      pwm => pwm,
      rst => rst
    );
end STRUCTURE;
