rFeijoo/FPGA_PID/PC4/6 - vivado/Interface_Arduino_Basys3.srcs/sources_1/ip/VIO_0/VIO_0_sim_netlist.v

// Copyright 1986-2018 Xilinx, Inc. All Rights Reserved.
// --------------------------------------------------------------------------------
// Tool Version: Vivado v.2018.3 (win64) Build 2405991 Thu Dec  6 23:38:27 MST 2018
// Date        : Tue Dec 15 05:30:55 2020
// Host        : RAFAELFEIJL2C3E running 64-bit major release  (build 9200)
// Command     : write_verilog -force -mode funcsim
//               C:/Mac/Home/Documents/Windows/Vivado/Projects/Interface_Arduino_Basys3/Interface_Arduino_Basys3.srcs/sources_1/ip/VIO_0/VIO_0_sim_netlist.v
// Design      : VIO_0
// Purpose     : This verilog netlist is a functional simulation representation of the design and should not be modified
//               or synthesized. This netlist cannot be used for SDF annotated simulation.
// Device      : xc7a35tcpg236-1
// --------------------------------------------------------------------------------
`timescale 1 ps / 1 ps

(* CHECK_LICENSE_TYPE = "VIO_0,vio,{}" *) (* X_CORE_INFO = "vio,Vivado 2018.3" *) 
(* NotValidForBitStream *)
module VIO_0
   (clk,
    probe_in0,
    probe_in1,
    probe_in2,
    probe_out0,
    probe_out1,
    probe_out2,
    probe_out3,
    probe_out4);
  input clk;
  input [31:0]probe_in0;
  input [0:0]probe_in1;
  input [7:0]probe_in2;
  output [0:0]probe_out0;
  output [31:0]probe_out1;
  output [31:0]probe_out2;
  output [31:0]probe_out3;
  output [31:0]probe_out4;

  wire clk;
  wire [31:0]probe_in0;
  wire [0:0]probe_in1;
  wire [7:0]probe_in2;
  wire [0:0]probe_out0;
  wire [31:0]probe_out1;
  wire [31:0]probe_out2;
  wire [31:0]probe_out3;
  wire [31:0]probe_out4;
  wire [0:0]NLW_inst_probe_out10_UNCONNECTED;
  wire [0:0]NLW_inst_probe_out100_UNCONNECTED;
  wire [0:0]NLW_inst_probe_out101_UNCONNECTED;
  wire [0:0]NLW_inst_probe_out102_UNCONNECTED;
  wire [0:0]NLW_inst_probe_out103_UNCONNECTED;
  wire [0:0]NLW_inst_probe_out104_UNCONNECTED;
  wire [0:0]NLW_inst_probe_out105_UNCONNECTED;
  wire [0:0]NLW_inst_probe_out106_UNCONNECTED;
  wire [0:0]NLW_inst_probe_out107_UNCONNECTED;
  wire [0:0]NLW_inst_probe_out108_UNCONNECTED;
  wire [0:0]NLW_inst_probe_out109_UNCONNECTED;
  wire [0:0]NLW_inst_probe_out11_UNCONNECTED;
  wire [0:0]NLW_inst_probe_out110_UNCONNECTED;
  wire [0:0]NLW_inst_probe_out111_UNCONNECTED;
  wire [0:0]NLW_inst_probe_out112_UNCONNECTED;
  wire [0:0]NLW_inst_probe_out113_UNCONNECTED;
  wire [0:0]NLW_inst_probe_out114_UNCONNECTED;
  wire [0:0]NLW_inst_probe_out115_UNCONNECTED;
  wire [0:0]NLW_inst_probe_out116_UNCONNECTED;
  wire [0:0]NLW_inst_probe_out117_UNCONNECTED;
  wire [0:0]NLW_inst_probe_out118_UNCONNECTED;
  wire [0:0]NLW_inst_probe_out119_UNCONNECTED;
  wire [0:0]NLW_inst_probe_out12_UNCONNECTED;
  wire [0:0]NLW_inst_probe_out120_UNCONNECTED;
  wire [0:0]NLW_inst_probe_out121_UNCONNECTED;
  wire [0:0]NLW_inst_probe_out122_UNCONNECTED;
  wire [0:0]NLW_inst_probe_out123_UNCONNECTED;
  wire [0:0]NLW_inst_probe_out124_UNCONNECTED;
  wire [0:0]NLW_inst_probe_out125_UNCONNECTED;
  wire [0:0]NLW_inst_probe_out126_UNCONNECTED;
  wire [0:0]NLW_inst_probe_out127_UNCONNECTED;
  wire [0:0]NLW_inst_probe_out128_UNCONNECTED;
  wire [0:0]NLW_inst_probe_out129_UNCONNECTED;
  wire [0:0]NLW_inst_probe_out13_UNCONNECTED;
  wire [0:0]NLW_inst_probe_out130_UNCONNECTED;
  wire [0:0]NLW_inst_probe_out131_UNCONNECTED;
  wire [0:0]NLW_inst_probe_out132_UNCONNECTED;
  wire [0:0]NLW_inst_probe_out133_UNCONNECTED;
  wire [0:0]NLW_inst_probe_out134_UNCONNECTED;
  wire [0:0]NLW_inst_probe_out135_UNCONNECTED;
  wire [0:0]NLW_inst_probe_out136_UNCONNECTED;
  wire [0:0]NLW_inst_probe_out137_UNCONNECTED;
  wire [0:0]NLW_inst_probe_out138_UNCONNECTED;
  wire [0:0]NLW_inst_probe_out139_UNCONNECTED;
  wire [0:0]NLW_inst_probe_out14_UNCONNECTED;
  wire [0:0]NLW_inst_probe_out140_UNCONNECTED;
  wire [0:0]NLW_inst_probe_out141_UNCONNECTED;
  wire [0:0]NLW_inst_probe_out142_UNCONNECTED;
  wire [0:0]NLW_inst_probe_out143_UNCONNECTED;
  wire [0:0]NLW_inst_probe_out144_UNCONNECTED;
  wire [0:0]NLW_inst_probe_out145_UNCONNECTED;
  wire [0:0]NLW_inst_probe_out146_UNCONNECTED;
  wire [0:0]NLW_inst_probe_out147_UNCONNECTED;
  wire [0:0]NLW_inst_probe_out148_UNCONNECTED;
  wire [0:0]NLW_inst_probe_out149_UNCONNECTED;
  wire [0:0]NLW_inst_probe_out15_UNCONNECTED;
  wire [0:0]NLW_inst_probe_out150_UNCONNECTED;
  wire [0:0]NLW_inst_probe_out151_UNCONNECTED;
  wire [0:0]NLW_inst_probe_out152_UNCONNECTED;
  wire [0:0]NLW_inst_probe_out153_UNCONNECTED;
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
        .probe_out82(NLW_inst_probe_out82_UNCONNECTED[0]),
        .probe_out83(NLW_inst_probe_out83_UNCONNECTED[0]),
        .probe_out84(NLW_inst_probe_out84_UNCONNECTED[0]),
        .probe_out85(NLW_inst_probe_out85_UNCONNECTED[0]),
        .probe_out86(NLW_inst_probe_out86_UNCONNECTED[0]),
        .probe_out87(NLW_inst_probe_out87_UNCONNECTED[0]),
        .probe_out88(NLW_inst_probe_out88_UNCONNECTED[0]),
        .probe_out89(NLW_inst_probe_out89_UNCONNECTED[0]),
        .probe_out9(NLW_inst_probe_out9_UNCONNECTED[0]),
        .probe_out90(NLW_inst_probe_out90_UNCONNECTED[0]),
        .probe_out91(NLW_inst_probe_out91_UNCONNECTED[0]),
        .probe_out92(NLW_inst_probe_out92_UNCONNECTED[0]),
        .probe_out93(NLW_inst_probe_out93_UNCONNECTED[0]),
        .probe_out94(NLW_inst_probe_out94_UNCONNECTED[0]),
        .probe_out95(NLW_inst_probe_out95_UNCONNECTED[0]),
        .probe_out96(NLW_inst_probe_out96_UNCONNECTED[0]),
        .probe_out97(NLW_inst_probe_out97_UNCONNECTED[0]),
        .probe_out98(NLW_inst_probe_out98_UNCONNECTED[0]),
        .probe_out99(NLW_inst_probe_out99_UNCONNECTED[0]),
        .sl_iport0({1'b0,1'b0,1'b0,1'b0,1'b0,1'b0,1'b0,1'b0,1'b0,1'b0,1'b0,1'b0,1'b0,1'b0,1'b0,1'b0,1'b0,1'b0,1'b0,1'b0,1'b0,1'b0,1'b0,1'b0,1'b0,1'b0,1'b0,1'b0,1'b0,1'b0,1'b0,1'b0,1'b0,1'b0,1'b0,1'b0,1'b0}),
        .sl_oport0(NLW_inst_sl_oport0_UNCONNECTED[16:0]));
endmodule
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
