rFeijoo/FPGA_PID/PC4/6 - vivado/Interface_Arduino_Basys3.srcs/sources_1/ip/floating_point_0/demo_tb/tb_floating_point_0.vhd

---------------------------------------------------------------------------
--
--  (c) Copyright 2011, 2012, 2015 Xilinx, Inc. All rights reserved.
--
--  This file contains confidential and proprietary information
--  of Xilinx, Inc. and is protected under U.S. and
--  international copyright and other intellectual property
--  laws.
--
--  DISCLAIMER
--  This disclaimer is not a license and does not grant any
--  rights to the materials distributed herewith. Except as
--  otherwise provided in a valid license issued to you by
--  Xilinx, and to the maximum extent permitted by applicable
--  law: (1) THESE MATERIALS ARE MADE AVAILABLE "AS IS" AND
--  WITH ALL FAULTS, AND XILINX HEREBY DISCLAIMS ALL WARRANTIES
--  AND CONDITIONS, EXPRESS, IMPLIED, OR STATUTORY, INCLUDING
--  BUT NOT LIMITED TO WARRANTIES OF MERCHANTABILITY, NON-
--  INFRINGEMENT, OR FITNESS FOR ANY PARTICULAR PURPOSE; and
--  (2) Xilinx shall not be liable (whether in contract or tort,
--  including negligence, or under any other theory of
--  liability) for any loss or damage of any kind or nature
--  related to, arising under or in connection with these
--  materials, including for any direct, or any indirect,
--  special, incidental, or consequential loss or damage
--  (including loss of data, profits, goodwill, or any type of
--  loss or damage suffered as a result of any action brought
--  by a third party) even if such damage or loss was
--  reasonably foreseeable or Xilinx had been advised of the
--  possibility of the same.
--
--  CRITICAL APPLICATIONS
--  Xilinx products are not designed or intended to be fail-
--  safe, or for use in any application requiring fail-safe
--  performance, such as life-support or safety devices or
--  systems, Class III medical devices, nuclear facilities,
--  applications related to the deployment of airbags, or any
--  other applications that could lead to death, personal
--  injury, or severe property or environmental damage
--  (individually and collectively, "Critical
--  Applications"). Customer assumes the sole risk and
--  liability of any use of Xilinx products in Critical
--  Applications, subject only to applicable laws and
--  regulations governing limitations on product liability.
--
--  THIS COPYRIGHT NOTICE AND DISCLAIMER MUST BE RETAINED AS
--  PART OF THIS FILE AT ALL TIMES.
--
---------------------------------------------------------------------------
-- Description:
-- This is an example testbench for the Floating-point IP core.
-- The testbench has been generated by Vivado to accompany the IP core
-- instance you have generated.
--
-- This testbench is for demonstration purposes only.  See note below for
-- instructions on how to use it with your core.
--
-- See the Floating Point Operator datasheet for further information about
-- this core.
--
---------------------------------------------------------------------------
-- Using this testbench
--
-- This testbench instantiates your generated Floating-point core
-- instance named "floating_point_0".
--
-- Use Vivado's Run Simulation flow to run this testbench.  See the Vivado
-- documentation for details.
---------------------------------------------------------------------------


library ieee;
use ieee.std_logic_1164.all;
use ieee.numeric_std.all;
use ieee.math_real.all;

entity tb_floating_point_0 is
end tb_floating_point_0;

architecture tb of tb_floating_point_0 is

  -----------------------------------------------------------------------
  -- Timing constants
  -----------------------------------------------------------------------
  constant CLOCK_PERIOD : time := 100 ns;
  constant T_HOLD       : time := 10 ns;
  constant T_STROBE     : time := CLOCK_PERIOD - (1 ns);
  constant DUT_DELAY    : time := CLOCK_PERIOD * 7;

  -----------------------------------------------------------------------
  -- Testbench types and signals
  -----------------------------------------------------------------------

  -- Overall simulation phase control enumerated type and signal
  type sim_phase_t is (phase_init,           -- test initialization, run no operations
                       phase_single,         -- run a single operation, and wait for the result
                       phase_consecutive,    -- run a consecutive series of 100 operations with incrementing data
                       phase_axi_handshake,  -- demonstrate the use and effect of AXI handshaking signals
                       phase_special         -- demonstrate the use of special floating-point values
                       );
  signal sim_phase : sim_phase_t := phase_init;

  -- Enumerated type to indicate special floating point values.
  -- Note: denormalized numbers are treated as zero, and signalling NaNs are treated as quiet NaNs.
  -- Out Of Range just means the value is larger than VHDL can support in a Real type
  type floating_point_special_t is (normal, zero_pos, zero_neg, inf_pos, inf_neg, nan, out_of_range);

  -----------------------------------------------------------------------
  -- Functions
  -----------------------------------------------------------------------

  -- Function to limit an integer bit width to a value for which functions can use VHDL's integer type for calculations
  function width_limit(w : integer) return integer is
    constant MAX_WIDTH : integer := 30;  -- maximum width: allows 2**width to be stored in an integer variable
  begin
    if w < MAX_WIDTH then
      return w;
    else
      return MAX_WIDTH;
    end if;
  end function width_limit;

  -- Function to convert a real number to a std_logic_vector floating point representation
  function real_to_flt(x : real;                       -- real number to convert
                       s : floating_point_special_t;   -- indicates special values to convert (overrides x)
                       w, fw : integer)                -- total and fractional bit width of result
    return std_logic_vector is
    constant EW       : integer := w - fw;
    constant FW_LIM   : integer := width_limit(fw);    -- limited internal value of fractional bit width
    constant E_BIAS   : integer := 2 ** (EW - 1) - 1;
    constant MANT_MAX : real    := 2.0 - 1.0 / real(2 ** (FW_LIM - 1));
    variable result   : std_logic_vector(w-1 downto 0) := (others => '0');
    variable sign     : std_logic := '0';
    variable exp      : integer   := 0;
    variable mant     : real;
    variable mant_int : integer;
  begin

    -- Handle special cases
    case s is
      when zero_pos =>  -- plus zero
        result(w-1) := '0';                          -- sign bit clear
        result(w-2 downto 0) := (others => '0');     -- exponent and mantissa clear

      when zero_neg =>  -- minus zero
        result(w-1) := '1';                          -- sign bit set
        result(w-2 downto 0) := (others => '0');     -- exponent and mantissa clear

      when inf_pos =>   -- plus infinity
        result(w-1) := '0';                          -- sign bit clear
        result(w-2 downto fw-1) := (others => '1');  -- exponent
        result(fw-2 downto 0)   := (others => '0');  -- mantissa

      when inf_neg =>   -- minus infinity
        result(w-1) := '1';                          -- sign bit set
        result(w-2 downto fw-1) := (others => '1');  -- exponent
        result(fw-2 downto 0)   := (others => '0');  -- mantissa

      when nan =>       -- Not a Number
        result(w-1) := '0';                          -- sign bit
        result(w-2 downto fw-1) := (others => '1');  -- exponent
        result(fw-2)            := '1';              -- MSB of mantissa set
        result(fw-3 downto 0)   := (others => '0');  -- rest of mantissa clear

      -- NOTE: out_of_range might be possible under some circumstances, but it can be represented
      when normal | out_of_range =>
        -- Handle normal numbers

        -- Zero must be requested using s = zero_pos or s = zero_neg, not s = normal and x = 0.0
        assert x /= 0.0
          report "ERROR: real_to_flt: zero must be requested using s = zero_pos or s = zero_neg, not s = normal and x = 0.0"
          severity failure;

        -- Get sign bit
        if x < 0.0 then
          sign := '1';
          mant := -x;
        else
          sign := '0';
          mant := x;
        end if;

        -- Normalize input to calculate exponent
        while mant < 1.0 loop
          exp  := exp - 1;
          mant := mant * 2.0;
        end loop;
        while mant > MANT_MAX loop
          exp  := exp + 1;
          mant := mant / 2.0;
        end loop;

        -- Remove hidden bit and convert to std_logic_vector
        -- To avoid VHDL's integer type overflowing, use at most 30 bits of the mantissa
        mant := mant - 1.0;
        mant_int := integer(mant * real(2 ** (FW_LIM - 1)));  -- implicit round-to-nearest
        result(fw - 2 downto fw - FW_LIM) := std_logic_vector(to_unsigned(mant_int, FW_LIM - 1));

        -- Add exponent bias and convert to std_logic_vector
        exp := exp + E_BIAS;
        result(w - 2 downto fw - 1) := std_logic_vector(to_unsigned(exp, EW));

        -- Add sign bit
        result(w - 1) := sign;

    end case;

    return result;
  end function real_to_flt;


  -- Function to identify special numbers in a std_logic_vector floating point representation
  function flt_to_special(f : std_logic_vector;  -- floating point number to convert
                          w, fw : integer)       -- total and fractional bit width of result
    return floating_point_special_t is
    constant EW     : integer := w - fw;
    constant ZEROS  : std_logic_vector(w-1 downto 0)    := (others => '0');
    constant ONES   : std_logic_vector(w-1 downto 0)    := (others => '1');
    variable f_int  : std_logic_vector(f'high downto 0) := f;  -- fixed width version of f
    variable f_sign : std_logic                         := f_int(w-1);              -- sign bit of f
    variable f_exp  : std_logic_vector(EW-1 downto 0)   := f_int(w-2 downto fw-1);  -- exponent of f
    variable f_mant : std_logic_vector(fw-2 downto 0)   := f_int(fw-2 downto 0);    -- mantissa of f
    variable result : floating_point_special_t;
    constant E_BIAS   : integer := 2 ** (EW - 1) - 1;
  begin

    -- Check bit widths match
    assert f'high = w - 1
      report "ERROR: flt_to_special: input std_logic_vector f must have bit width = input integer w"
      severity failure;

    -- Check for special cases
    if f_exp = ZEROS(w-2 downto fw-1) then
      -- +/- zero (treat denormalized numbers as zero)
      if f_sign = '0' then
        result := zero_pos;
      else
        result := zero_neg;
      end if;

    elsif f_exp = ONES(w-2 downto fw-1) then
      if f_mant = ZEROS(fw-2 downto 0) then
        -- +/- infinity
        if f_sign = '0' then
          result := inf_pos;
        else
          result := inf_neg;
        end if;

      else
        -- NaN (not a number)
        result := nan;
      end if;
    elsif to_integer(unsigned(f_exp)) - E_BIAS > 1022 then
      -- If the exponent is too large then we end up with a number that VHDL can't represent in a REAL.
      -- This gives fatal runtime errors.  Note that 1022 is used instead of 1023 (the actual max) because
      -- that allows us to ignore the value of the mantissa

      result := out_of_range;
    elsif to_integer(unsigned(f_exp)) - E_BIAS < -1021 then
      result := out_of_range;

    else
      -- not a special case
      result := normal;
    end if;

    return result;
  end function flt_to_special;

  -- Function to convert a std_logic_vector floating point representation into a real number
  function flt_to_real(f : std_logic_vector;  -- floating point number to convert
                       w, fw : integer)       -- total and fractional bit width of result
    return real is
    constant EW     : integer := w - fw;
    constant FW_LIM : integer := width_limit(fw);    -- limited internal value of fractional bit width
    constant E_BIAS : integer := 2 ** (EW - 1) - 1;
    constant ZEROS  : std_logic_vector(w-1 downto 0)    := (others => '0');
    variable f_int  : std_logic_vector(f'high downto 0) := f;  -- fixed width version of f
    variable f_sign : std_logic                         := f_int(w-1);              -- sign bit of f
    variable f_exp  : std_logic_vector(EW-1 downto 0)   := f_int(w-2 downto fw-1);  -- exponent of f
    variable f_mant : std_logic_vector(fw-2 downto 0)   := f_int(fw-2 downto 0);    -- mantissa of f
    variable exp    : integer;
    variable result : real;
  begin

    -- Check bit widths match
    assert f'high = w - 1
      report "ERROR: flt_to_real: input std_logic_vector f must have bit width = input integer w"
      severity failure;

    -- Check for special cases: return zero if any are found
    if flt_to_special(f, w, fw) /= normal then
      result := 0.0;
    else

      -- Convert mantissa to real
      -- To avoid VHDL's integer type overflowing, consider at most 30 bits of the mantissa
      result := real(to_integer(unsigned(f_mant(fw - 2 downto fw - FW_LIM)))) / real(2 ** (FW_LIM - 1)) + 1.0;

      -- Apply exponent
      exp := to_integer(unsigned(f_exp)) - E_BIAS;
      if exp > 0 then
        result := result * (2.0 ** real(exp));
      elsif exp < 0 then
        result := result / (2.0 ** real(-exp));
      end if;

      -- Apply sign bit
      if f_sign = '1' then
        result := -result;
      end if;

    end if;

    return result;
  end function flt_to_real;

  -- Function to convert a std_logic_vector fixed point representation into a real number
  function fix_to_real(f : std_logic_vector;  -- fixed point number to convert
                       w, fw : integer)       -- total and fractional bit width of result
    return real is
    constant IW           : integer := w - fw;             -- integer bit width including sign bit
    constant FW_LIM       : integer := width_limit(fw);    -- limited internal value of fractional bit width
    constant IW_LIM       : integer := width_limit(IW);    -- limited internal value of integer bit width
    variable f_int        : std_logic_vector(f'high downto 0) := f;  -- fixed width version of f
    variable result_int   : integer;
    variable result_fract : real;
    variable result       : real;
  begin

    -- Check bit widths match
    assert f'high = w - 1
      report "ERROR: fix_to_real: input std_logic_vector f must have bit width = input integer w"
      severity failure;

    -- 1 bit integer (sign bit only) is a special case: treat whole of f as a signed fractional part
    if IW = 1 then
      result := real(to_integer(signed(f_int(w-1 downto w - IW - FW_LIM)))) / real(2 ** FW_LIM);

    else  -- general case
      -- Convert integer part (signed)
      -- To avoid VHDL's integer type overflowing, consider at most 30 bits of the integer part.
      -- This means that very large integer parts (> 2**30) will be misconverted as MSBS are ignored
      result_int := to_integer(signed(f_int(fw + IW_LIM - 1 downto fw)));

      -- Convert fractional part (treat as unsigned)
      -- To avoid VHDL's integer type overflowing, consider at most 30 bits of the fractional part.
      result_fract := real(to_integer(unsigned(f_int(fw - 1 downto fw - FW_LIM)))) / real(2 ** FW_LIM);

      -- Combine the parts
      result := real(result_int) + result_fract;
    end if;

    return result;
  end function fix_to_real;


  -----------------------------------------------------------------------
  -- DUT signals
  -----------------------------------------------------------------------

  -- Global signals
  signal aclk                    : std_logic := '0';  -- the master clock

  -- A operand slave channel signals
  signal s_axis_a_tvalid         : std_logic := '0';  -- payload is valid
  signal s_axis_a_tready         : std_logic := '1';  -- slave is ready
  signal s_axis_a_tdata          : std_logic_vector(31 downto 0) := (others => '0');  -- data payload

  -- Result master channel signals
  signal m_axis_result_tvalid    : std_logic := '0';
  signal m_axis_result_tready    : std_logic := '1';
  signal m_axis_result_tdata     : std_logic_vector(31 downto 0) := (others => '0');  -- data payload

  -----------------------------------------------------------------------
  -- Aliases for AXI channel TDATA and TUSER fields
  -- These are a convenience for viewing data in a simulator waveform viewer.
  -- If using ModelSim or Questa, add "-voptargs=+acc=n" to the vsim command
  -- to prevent the simulator optimizing away these signals.
  -----------------------------------------------------------------------

  -- A operand slave channel alias signals
  signal s_axis_a_tdata_real    : real := 0.0;  -- floating-point value using VHDL 'real' data type
  signal s_axis_a_tdata_special : floating_point_special_t := normal;  -- indicate special values
  signal s_axis_a_tdata_sign    : std_logic := '0';  -- sign bit
  signal s_axis_a_tdata_exp     : std_logic_vector(7 downto 0) := (others => '0');  -- exponent (biased)
  signal s_axis_a_tdata_mant    : std_logic_vector(22 downto 0) := (others => '0');  -- mantissa (without hidden bit)



  -- Result master channel alias signals
  signal m_axis_result_tdata_real     : real := 0.0;  -- fixed-point value using VHDL 'real' data type
  signal m_axis_result_tdata_int      : std_logic_vector(31 downto 0) := (others => '0');  -- integer part (including sign bit)

begin

  -----------------------------------------------------------------------
  -- Instantiate the DUT
  -----------------------------------------------------------------------

  dut : entity work.floating_point_0
    port map (
      -- Global signals
      aclk                    => aclk,
    -- AXI4-Stream slave channel for operand A
      s_axis_a_tvalid         => s_axis_a_tvalid,
      s_axis_a_tready         => s_axis_a_tready,
      s_axis_a_tdata          => s_axis_a_tdata,
      -- AXI4-Stream master channel for output result
      m_axis_result_tvalid    => m_axis_result_tvalid,
      m_axis_result_tready    => m_axis_result_tready,
      m_axis_result_tdata     => m_axis_result_tdata
      );


  -----------------------------------------------------------------------
  -- Generate clock
  -----------------------------------------------------------------------

  clock_gen : process
  begin
    aclk <= '0';
    wait for CLOCK_PERIOD;
    loop
      aclk <= '0';
      wait for CLOCK_PERIOD/2;
      aclk <= '1';
      wait for CLOCK_PERIOD/2;
    end loop;
  end process clock_gen;


  -----------------------------------------------------------------------
  -- Simulation control
  -- Run a series of demonstrations, each in a separate test phase
  -- This process controls all other stimuli processes
  -----------------------------------------------------------------------

  sim_control : process
  begin

    -- Drive simulation control synchronous to the rising edge of the clock
    wait until rising_edge(aclk);

    -- Run a single operation, and wait for the result
    sim_phase <= phase_single;

    wait for 5 * CLOCK_PERIOD + DUT_DELAY;
    -- Run a consecutive series of 100 operations with incrementing data and wait for all results
    sim_phase <= phase_consecutive;
    wait for 105 * CLOCK_PERIOD + DUT_DELAY;


    -- Run the same consecutive series of 100 operations, while demonstrating use and effect of AXI handshaking signals
    sim_phase <= phase_axi_handshake;
    wait for 132 * CLOCK_PERIOD;


    -- Run operations that demonstrate the use of special floating-point values (+/- zero, +/- infinity, Not a Number)
    sim_phase <= phase_special;
    wait for 12 * CLOCK_PERIOD;
    -- Allow operations in progress to complete and the results to be produced
    wait for DUT_DELAY;

    -- End of simulation
    report "Not a real failure. Simulation finished successfully. Test completed successfully" severity failure;
    wait;

  end process sim_control;


  -----------------------------------------------------------------------
  -- Generate inputs on the A operand slave channel
  -- This process also drives:
  -- + RESULT master channel TREADY input
  -----------------------------------------------------------------------

  stimuli_a : process

    -- Procedure to drive a single transaction on the A channel
    procedure drive_a_single(tdata : std_logic_vector(31 downto 0);
                             variable abort : out boolean) is
    begin
      -- Drive AXI signals
      s_axis_a_tvalid <= '1';
      s_axis_a_tdata  <= tdata;
      abort := false;
      loop
        wait until rising_edge(aclk);
        exit when s_axis_a_tready = '1';
      end loop;
      wait for T_HOLD;
      s_axis_a_tvalid <= '0';
    end procedure drive_a_single;

    -- Procedure to drive a series of transactions with incrementing data values on the A channel.
    -- data is the data value for the first transaction
    -- special indicates special floating-point values, and overrides data
    -- count is the number of transactions to drive
    -- step is the increment to add to the data value on each successive transaction
    procedure drive_a(data    : real;
                      special : floating_point_special_t;
                      count   : positive := 1;
                      step    : real     := 0.0) is
      variable value     : real := data;
      variable value_slv : std_logic_vector(31 downto 0);
      variable tdata     : std_logic_vector(31 downto 0);
      variable ip_count  : natural := 0;
      variable abort     : boolean;
    begin
      count_loop : loop
        -- Convert data from real to std_logic_vector
        value_slv := real_to_flt(value, special, 32, 24);
        -- Set up AXI signals
        tdata := value_slv;
        -- Drive AXI transaction
        drive_a_single(tdata => tdata,
                       abort => abort);

        ip_count := ip_count + 1;
        exit count_loop when ip_count >= count;
        -- Increment data for next iteration
        value := value + step;
      end loop count_loop;
    end procedure drive_a;





    variable tdata : std_logic_vector(31 downto 0) := (others => '0');
    variable abort : boolean;

  begin

    -- Wait for simulation control to signal the first phase
    wait until sim_phase = phase_single;
    wait for T_HOLD;  -- drive inputs T_HOLD after the rising edge of the clock

    -- Run a single operation, and wait for the result
    drive_a(1.0, normal);


    -- Wait for simulation control to signal the next phase
    wait until sim_phase = phase_consecutive;
    wait for T_HOLD;  -- drive inputs T_HOLD after the rising edge of the clock


    -- Run a consecutive series of 100 operations with incrementing data
    drive_a(0.1, normal, 100, 0.1);

    -- Wait for simulation control to signal the next phase
    wait until sim_phase = phase_axi_handshake;
    wait for T_HOLD;  -- drive inputs T_HOLD after the rising edge of the clock

    -- Run the same consecutive series of 100 operations, while demonstrating use and effect of AXI handshaking signals
    -- 5 normal consecutive transactions
    drive_a(0.1, normal, 5, 0.1);
    -- No transactions for 5 clock cycles
    wait for 5 * CLOCK_PERIOD;
    -- 25 normal consecutive transactions
    drive_a(0.6, normal, 25, 0.1);
    -- No transactions for 15 clock cycles
    wait for 15 * CLOCK_PERIOD;
    -- 20 normal consecutive transactions
    drive_a(3.1, normal, 20, 0.1);
    -- Apply backpressure (not ready for result) for 10 clock cycles, then release
    m_axis_result_tready <= '0', '1' after 10 * CLOCK_PERIOD;
  -- 50 normal consecutive transactions
  drive_a(5.1, normal, 50, 0.1);

    -- Wait for simulation control to signal the next phase
    wait until sim_phase = phase_special;
    wait for T_HOLD;  -- drive inputs T_HOLD after the rising edge of the clock

    -- Run operations that demonstrate the use of special floating-point values (+/- zero, +/- infinity, Not a Number)
    -- flt_to_fix(plus zero) : result = zero
    drive_a(0.0, zero_pos);
    -- flt_to_fix(minus zero) : result = zero
    drive_a(0.0, zero_neg);
    -- flt_to_fix(plus infinity) : invalid operation, overflow, result = largest positive fixed point number available
    drive_a(0.0, inf_pos);
    -- flt_to_fix(minus infinity) : invalid operation, overflow, result = largest negative fixed point number available
    drive_a(0.0, inf_neg);
    -- flt_to_fix(very large number) : overflow, result = largest positive fixed point number available
    tdata(31) := '0';  -- sign bit
    tdata(30 downto 23) := std_logic_vector(to_unsigned(254, 8));  -- biased exponent = largest
    tdata(22 downto 0) := (others => '1');  -- mantissa without hidden bit = largest
    drive_a_single(tdata, abort);
    -- flt_to_fix(-(very large number)) : overflow, result = largest negative fixed point number available
    tdata(31) := '1';  -- sign bit
    tdata(30 downto 23) := std_logic_vector(to_unsigned(254, 8));  -- biased exponent = largest
    tdata(22 downto 0) := (others => '1');  -- mantissa without hidden bit = largest
    drive_a_single(tdata, abort);
    -- flt_to_fix(Not a Number) : invalid operation, result = largest negative fixed point number available
    drive_a(0.0, nan);
    -- End of test
    wait;

  end process stimuli_a;




  -----------------------------------------------------------------------
  -- Check outputs
  -----------------------------------------------------------------------

  check_outputs : process
    variable check_ok : boolean := true;
    -- Previous values of RESULT master channel signals
    variable result_tvalid_prev : std_logic := '0';
    variable result_tready_prev : std_logic := '1';
    variable result_tdata_prev  : std_logic_vector(31 downto 0) := (others => '0');
  begin

    -- Check outputs T_STROBE time after rising edge of clock
    wait until rising_edge(aclk);
    wait for T_STROBE;

    -- Do not check the output payload values, as this requires the behavioral model
    -- which would make this demonstration testbench unwieldy.
    -- Instead, check the protocol of the RESULT master channel:
    -- check that the payload is valid (not X) when TVALID is high
    -- and check that the payload does not change while TVALID is high until TREADY goes high

    if m_axis_result_tvalid = '1' then
      if is_x(m_axis_result_tdata) then
        report "ERROR: m_axis_result_tdata is invalid when m_axis_result_tvalid is high" severity error;
        check_ok := false;
      end if;

      if result_tvalid_prev = '1' and result_tready_prev = '0' then  -- payload must be the same as last cycle
        if m_axis_result_tdata /= result_tdata_prev then
          report "ERROR: m_axis_result_tdata changed while m_axis_result_tvalid was high and m_axis_result_tready was low" severity error;
          check_ok := false;
        end if;
      end if;

    end if;

    assert check_ok
      report "ERROR: terminating test with failures." severity failure;

    -- Record payload values for checking next clock cycle
    if check_ok then
      result_tvalid_prev := m_axis_result_tvalid;
      result_tready_prev := m_axis_result_tready;
      result_tdata_prev  := m_axis_result_tdata;
    end if;

  end process check_outputs;


  -----------------------------------------------------------------------
  -- Assign TDATA / TUSER fields to aliases, for easy simulator waveform viewing
  -----------------------------------------------------------------------

  -- A operand slave channel alias signals
  s_axis_a_tdata_real    <= flt_to_real(s_axis_a_tdata(31 downto 0), 32, 24);
  s_axis_a_tdata_special <= flt_to_special(s_axis_a_tdata(31 downto 0), 32, 24);
  s_axis_a_tdata_sign    <= s_axis_a_tdata(31);
  s_axis_a_tdata_exp     <= s_axis_a_tdata(30 downto 23);
  s_axis_a_tdata_mant    <= s_axis_a_tdata(22 downto 0);

  -- Result master channel alias signals
  m_axis_result_tdata_real     <= fix_to_real(m_axis_result_tdata(31 downto 0), 32, 0) when m_axis_result_tvalid = '1';
  m_axis_result_tdata_int      <= m_axis_result_tdata(31 downto 0) when m_axis_result_tvalid = '1';

end tb;
