rFeijoo/FPGA_PID/PC4/6 - vivado/Interface_Arduino_Basys3.srcs/sources_1/ip/floating_point_0/floating_point_0_sim_netlist.v

// Copyright 1986-2018 Xilinx, Inc. All Rights Reserved.
// --------------------------------------------------------------------------------
// Tool Version: Vivado v.2018.3 (win64) Build 2405991 Thu Dec  6 23:38:27 MST 2018
// Date        : Tue Dec 15 04:11:40 2020
// Host        : RAFAELFEIJL2C3E running 64-bit major release  (build 9200)
// Command     : write_verilog -force -mode funcsim
//               c:/Mac/Home/Documents/Windows/Vivado/Projects/Interface_Arduino_Basys3/Interface_Arduino_Basys3.srcs/sources_1/ip/floating_point_0/floating_point_0_sim_netlist.v
// Design      : floating_point_0
// Purpose     : This verilog netlist is a functional simulation representation of the design and should not be modified
//               or synthesized. This netlist cannot be used for SDF annotated simulation.
// Device      : xc7a35tcpg236-1
// --------------------------------------------------------------------------------
`timescale 1 ps / 1 ps

(* CHECK_LICENSE_TYPE = "floating_point_0,floating_point_v7_1_7,{}" *) (* downgradeipidentifiedwarnings = "yes" *) (* x_core_info = "floating_point_v7_1_7,Vivado 2018.3" *) 
(* NotValidForBitStream *)
module floating_point_0
   (aclk,
    s_axis_a_tvalid,
    s_axis_a_tready,
    s_axis_a_tdata,
    m_axis_result_tvalid,
    m_axis_result_tready,
    m_axis_result_tdata);
  (* x_interface_info = "xilinx.com:signal:clock:1.0 aclk_intf CLK" *) (* x_interface_parameter = "XIL_INTERFACENAME aclk_intf, ASSOCIATED_BUSIF S_AXIS_OPERATION:M_AXIS_RESULT:S_AXIS_C:S_AXIS_B:S_AXIS_A, ASSOCIATED_RESET aresetn, ASSOCIATED_CLKEN aclken, FREQ_HZ 10000000, PHASE 0.000, INSERT_VIP 0" *) input aclk;
  (* x_interface_info = "xilinx.com:interface:axis:1.0 S_AXIS_A TVALID" *) (* x_interface_parameter = "XIL_INTERFACENAME S_AXIS_A, TDATA_NUM_BYTES 4, TDEST_WIDTH 0, TID_WIDTH 0, TUSER_WIDTH 0, HAS_TREADY 1, HAS_TSTRB 0, HAS_TKEEP 0, HAS_TLAST 0, FREQ_HZ 100000000, PHASE 0.000, LAYERED_METADATA undef, INSERT_VIP 0" *) input s_axis_a_tvalid;
  (* x_interface_info = "xilinx.com:interface:axis:1.0 S_AXIS_A TREADY" *) output s_axis_a_tready;
  (* x_interface_info = "xilinx.com:interface:axis:1.0 S_AXIS_A TDATA" *) input [31:0]s_axis_a_tdata;
  (* x_interface_info = "xilinx.com:interface:axis:1.0 M_AXIS_RESULT TVALID" *) (* x_interface_parameter = "XIL_INTERFACENAME M_AXIS_RESULT, TDATA_NUM_BYTES 4, TDEST_WIDTH 0, TID_WIDTH 0, TUSER_WIDTH 0, HAS_TREADY 1, HAS_TSTRB 0, HAS_TKEEP 0, HAS_TLAST 0, FREQ_HZ 100000000, PHASE 0.000, LAYERED_METADATA undef, INSERT_VIP 0" *) output m_axis_result_tvalid;
  (* x_interface_info = "xilinx.com:interface:axis:1.0 M_AXIS_RESULT TREADY" *) input m_axis_result_tready;
  (* x_interface_info = "xilinx.com:interface:axis:1.0 M_AXIS_RESULT TDATA" *) output [31:0]m_axis_result_tdata;

  wire aclk;
  wire [31:0]m_axis_result_tdata;
  wire m_axis_result_tready;
  wire m_axis_result_tvalid;
  wire [31:0]s_axis_a_tdata;
  wire s_axis_a_tready;
  wire s_axis_a_tvalid;
  wire NLW_U0_m_axis_result_tlast_UNCONNECTED;
  wire NLW_U0_s_axis_b_tready_UNCONNECTED;
  wire NLW_U0_s_axis_c_tready_UNCONNECTED;
  wire NLW_U0_s_axis_operation_tready_UNCONNECTED;
  wire [0:0]NLW_U0_m_axis_result_tuser_UNCONNECTED;

  (* C_ACCUM_INPUT_MSB = "32" *) 
  (* C_ACCUM_LSB = "-31" *) 
  (* C_ACCUM_MSB = "32" *) 
  (* C_A_FRACTION_WIDTH = "24" *) 
  (* C_A_TDATA_WIDTH = "32" *) 
  (* C_A_TUSER_WIDTH = "1" *) 
  (* C_A_WIDTH = "32" *) 
  (* C_BRAM_USAGE = "0" *) 
  (* C_B_FRACTION_WIDTH = "24" *) 
  (* C_B_TDATA_WIDTH = "32" *) 
  (* C_B_TUSER_WIDTH = "1" *) 
  (* C_B_WIDTH = "32" *) 
  (* C_COMPARE_OPERATION = "8" *) 
  (* C_C_FRACTION_WIDTH = "24" *) 
  (* C_C_TDATA_WIDTH = "32" *) 
  (* C_C_TUSER_WIDTH = "1" *) 
  (* C_C_WIDTH = "32" *) 
  (* C_FIXED_DATA_UNSIGNED = "0" *) 
  (* C_HAS_ABSOLUTE = "0" *) 
  (* C_HAS_ACCUMULATOR_A = "0" *) 
  (* C_HAS_ACCUMULATOR_S = "0" *) 
  (* C_HAS_ACCUM_INPUT_OVERFLOW = "0" *) 
  (* C_HAS_ACCUM_OVERFLOW = "0" *) 
  (* C_HAS_ACLKEN = "0" *) 
  (* C_HAS_ADD = "0" *) 
  (* C_HAS_ARESETN = "0" *) 
  (* C_HAS_A_TLAST = "0" *) 
  (* C_HAS_A_TUSER = "0" *) 
  (* C_HAS_B = "0" *) 
  (* C_HAS_B_TLAST = "0" *) 
  (* C_HAS_B_TUSER = "0" *) 
  (* C_HAS_C = "0" *) 
  (* C_HAS_COMPARE = "0" *) 
  (* C_HAS_C_TLAST = "0" *) 
  (* C_HAS_C_TUSER = "0" *) 
  (* C_HAS_DIVIDE = "0" *) 
  (* C_HAS_DIVIDE_BY_ZERO = "0" *) 
  (* C_HAS_EXPONENTIAL = "0" *) 
  (* C_HAS_FIX_TO_FLT = "0" *) 
  (* C_HAS_FLT_TO_FIX = "1" *) 
  (* C_HAS_FLT_TO_FLT = "0" *) 
  (* C_HAS_FMA = "0" *) 
  (* C_HAS_FMS = "0" *) 
  (* C_HAS_INVALID_OP = "0" *) 
  (* C_HAS_LOGARITHM = "0" *) 
  (* C_HAS_MULTIPLY = "0" *) 
  (* C_HAS_OPERATION = "0" *) 
  (* C_HAS_OPERATION_TLAST = "0" *) 
  (* C_HAS_OPERATION_TUSER = "0" *) 
  (* C_HAS_OVERFLOW = "0" *) 
  (* C_HAS_RECIP = "0" *) 
  (* C_HAS_RECIP_SQRT = "0" *) 
  (* C_HAS_RESULT_TLAST = "0" *) 
  (* C_HAS_RESULT_TUSER = "0" *) 
  (* C_HAS_SQRT = "0" *) 
  (* C_HAS_SUBTRACT = "0" *) 
  (* C_HAS_UNDERFLOW = "0" *) 
  (* C_LATENCY = "7" *) 
  (* C_MULT_USAGE = "0" *) 
  (* C_OPERATION_TDATA_WIDTH = "8" *) 
  (* C_OPERATION_TUSER_WIDTH = "1" *) 
  (* C_OPTIMIZATION = "1" *) 
  (* C_RATE = "1" *) 
  (* C_RESULT_FRACTION_WIDTH = "0" *) 
  (* C_RESULT_TDATA_WIDTH = "32" *) 
  (* C_RESULT_TUSER_WIDTH = "1" *) 
  (* C_RESULT_WIDTH = "32" *) 
  (* C_THROTTLE_SCHEME = "1" *) 
  (* C_TLAST_RESOLUTION = "0" *) 
  (* C_XDEVICEFAMILY = "artix7" *) 
  (* downgradeipidentifiedwarnings = "yes" *) 
  floating_point_0_floating_point_v7_1_7 U0
       (.aclk(aclk),
        .aclken(1'b1),
        .aresetn(1'b1),
        .m_axis_result_tdata(m_axis_result_tdata),
        .m_axis_result_tlast(NLW_U0_m_axis_result_tlast_UNCONNECTED),
        .m_axis_result_tready(m_axis_result_tready),
        .m_axis_result_tuser(NLW_U0_m_axis_result_tuser_UNCONNECTED[0]),
        .m_axis_result_tvalid(m_axis_result_tvalid),
        .s_axis_a_tdata(s_axis_a_tdata),
        .s_axis_a_tlast(1'b0),
        .s_axis_a_tready(s_axis_a_tready),
        .s_axis_a_tuser(1'b0),
        .s_axis_a_tvalid(s_axis_a_tvalid),
        .s_axis_b_tdata({1'b0,1'b0,1'b0,1'b0,1'b0,1'b0,1'b0,1'b0,1'b0,1'b0,1'b0,1'b0,1'b0,1'b0,1'b0,1'b0,1'b0,1'b0,1'b0,1'b0,1'b0,1'b0,1'b0,1'b0,1'b0,1'b0,1'b0,1'b0,1'b0,1'b0,1'b0,1'b0}),
        .s_axis_b_tlast(1'b0),
        .s_axis_b_tready(NLW_U0_s_axis_b_tready_UNCONNECTED),
        .s_axis_b_tuser(1'b0),
        .s_axis_b_tvalid(1'b0),
        .s_axis_c_tdata({1'b0,1'b0,1'b0,1'b0,1'b0,1'b0,1'b0,1'b0,1'b0,1'b0,1'b0,1'b0,1'b0,1'b0,1'b0,1'b0,1'b0,1'b0,1'b0,1'b0,1'b0,1'b0,1'b0,1'b0,1'b0,1'b0,1'b0,1'b0,1'b0,1'b0,1'b0,1'b0}),
        .s_axis_c_tlast(1'b0),
        .s_axis_c_tready(NLW_U0_s_axis_c_tready_UNCONNECTED),
        .s_axis_c_tuser(1'b0),
        .s_axis_c_tvalid(1'b0),
        .s_axis_operation_tdata({1'b0,1'b0,1'b0,1'b0,1'b0,1'b0,1'b0,1'b0}),
        .s_axis_operation_tlast(1'b0),
        .s_axis_operation_tready(NLW_U0_s_axis_operation_tready_UNCONNECTED),
        .s_axis_operation_tuser(1'b0),
        .s_axis_operation_tvalid(1'b0));
endmodule

(* C_ACCUM_INPUT_MSB = "32" *) (* C_ACCUM_LSB = "-31" *) (* C_ACCUM_MSB = "32" *) 
(* C_A_FRACTION_WIDTH = "24" *) (* C_A_TDATA_WIDTH = "32" *) (* C_A_TUSER_WIDTH = "1" *) 
(* C_A_WIDTH = "32" *) (* C_BRAM_USAGE = "0" *) (* C_B_FRACTION_WIDTH = "24" *) 
(* C_B_TDATA_WIDTH = "32" *) (* C_B_TUSER_WIDTH = "1" *) (* C_B_WIDTH = "32" *) 
(* C_COMPARE_OPERATION = "8" *) (* C_C_FRACTION_WIDTH = "24" *) (* C_C_TDATA_WIDTH = "32" *) 
(* C_C_TUSER_WIDTH = "1" *) (* C_C_WIDTH = "32" *) (* C_FIXED_DATA_UNSIGNED = "0" *) 
(* C_HAS_ABSOLUTE = "0" *) (* C_HAS_ACCUMULATOR_A = "0" *) (* C_HAS_ACCUMULATOR_S = "0" *) 
(* C_HAS_ACCUM_INPUT_OVERFLOW = "0" *) (* C_HAS_ACCUM_OVERFLOW = "0" *) (* C_HAS_ACLKEN = "0" *) 
(* C_HAS_ADD = "0" *) (* C_HAS_ARESETN = "0" *) (* C_HAS_A_TLAST = "0" *) 
(* C_HAS_A_TUSER = "0" *) (* C_HAS_B = "0" *) (* C_HAS_B_TLAST = "0" *) 
(* C_HAS_B_TUSER = "0" *) (* C_HAS_C = "0" *) (* C_HAS_COMPARE = "0" *) 
(* C_HAS_C_TLAST = "0" *) (* C_HAS_C_TUSER = "0" *) (* C_HAS_DIVIDE = "0" *) 
(* C_HAS_DIVIDE_BY_ZERO = "0" *) (* C_HAS_EXPONENTIAL = "0" *) (* C_HAS_FIX_TO_FLT = "0" *) 
(* C_HAS_FLT_TO_FIX = "1" *) (* C_HAS_FLT_TO_FLT = "0" *) (* C_HAS_FMA = "0" *) 
(* C_HAS_FMS = "0" *) (* C_HAS_INVALID_OP = "0" *) (* C_HAS_LOGARITHM = "0" *) 
(* C_HAS_MULTIPLY = "0" *) (* C_HAS_OPERATION = "0" *) (* C_HAS_OPERATION_TLAST = "0" *) 
(* C_HAS_OPERATION_TUSER = "0" *) (* C_HAS_OVERFLOW = "0" *) (* C_HAS_RECIP = "0" *) 
(* C_HAS_RECIP_SQRT = "0" *) (* C_HAS_RESULT_TLAST = "0" *) (* C_HAS_RESULT_TUSER = "0" *) 
(* C_HAS_SQRT = "0" *) (* C_HAS_SUBTRACT = "0" *) (* C_HAS_UNDERFLOW = "0" *) 
(* C_LATENCY = "7" *) (* C_MULT_USAGE = "0" *) (* C_OPERATION_TDATA_WIDTH = "8" *) 
(* C_OPERATION_TUSER_WIDTH = "1" *) (* C_OPTIMIZATION = "1" *) (* C_RATE = "1" *) 
(* C_RESULT_FRACTION_WIDTH = "0" *) (* C_RESULT_TDATA_WIDTH = "32" *) (* C_RESULT_TUSER_WIDTH = "1" *) 
(* C_RESULT_WIDTH = "32" *) (* C_THROTTLE_SCHEME = "1" *) (* C_TLAST_RESOLUTION = "0" *) 
(* C_XDEVICEFAMILY = "artix7" *) (* ORIG_REF_NAME = "floating_point_v7_1_7" *) (* downgradeipidentifiedwarnings = "yes" *) 
module floating_point_0_floating_point_v7_1_7
   (aclk,
    aclken,
    aresetn,
    s_axis_a_tvalid,
    s_axis_a_tready,
    s_axis_a_tdata,
    s_axis_a_tuser,
    s_axis_a_tlast,
    s_axis_b_tvalid,
    s_axis_b_tready,
    s_axis_b_tdata,
    s_axis_b_tuser,
    s_axis_b_tlast,
    s_axis_c_tvalid,
    s_axis_c_tready,
    s_axis_c_tdata,
    s_axis_c_tuser,
    s_axis_c_tlast,
    s_axis_operation_tvalid,
    s_axis_operation_tready,
    s_axis_operation_tdata,
    s_axis_operation_tuser,
    s_axis_operation_tlast,
    m_axis_result_tvalid,
    m_axis_result_tready,
    m_axis_result_tdata,
    m_axis_result_tuser,
    m_axis_result_tlast);
  input aclk;
  input aclken;
  input aresetn;
  input s_axis_a_tvalid;
  output s_axis_a_tready;
  input [31:0]s_axis_a_tdata;
  input [0:0]s_axis_a_tuser;
  input s_axis_a_tlast;
  input s_axis_b_tvalid;
  output s_axis_b_tready;
  input [31:0]s_axis_b_tdata;
  input [0:0]s_axis_b_tuser;
  input s_axis_b_tlast;
  input s_axis_c_tvalid;
  output s_axis_c_tready;
  input [31:0]s_axis_c_tdata;
  input [0:0]s_axis_c_tuser;
  input s_axis_c_tlast;
  input s_axis_operation_tvalid;
  output s_axis_operation_tready;
  input [7:0]s_axis_operation_tdata;
  input [0:0]s_axis_operation_tuser;
  input s_axis_operation_tlast;
  output m_axis_result_tvalid;
  input m_axis_result_tready;
  output [31:0]m_axis_result_tdata;
  output [0:0]m_axis_result_tuser;
  output m_axis_result_tlast;

  wire \<const0> ;
  wire \<const1> ;
  wire aclk;
  wire [31:0]m_axis_result_tdata;
  wire m_axis_result_tready;
  wire m_axis_result_tvalid;
  wire [31:0]s_axis_a_tdata;
  wire s_axis_a_tready;
  wire s_axis_a_tvalid;
  wire NLW_i_synth_m_axis_result_tlast_UNCONNECTED;
  wire NLW_i_synth_s_axis_b_tready_UNCONNECTED;
  wire NLW_i_synth_s_axis_c_tready_UNCONNECTED;
  wire NLW_i_synth_s_axis_operation_tready_UNCONNECTED;
  wire [0:0]NLW_i_synth_m_axis_result_tuser_UNCONNECTED;

  assign m_axis_result_tlast = \<const0> ;
  assign m_axis_result_tuser[0] = \<const0> ;
  assign s_axis_b_tready = \<const1> ;
  assign s_axis_c_tready = \<const1> ;
  assign s_axis_operation_tready = \<const1> ;
  GND GND
       (.G(\<const0> ));
  VCC VCC
       (.P(\<const1> ));
  (* C_ACCUM_INPUT_MSB = "32" *) 
  (* C_ACCUM_LSB = "-31" *) 
  (* C_ACCUM_MSB = "32" *) 
  (* C_A_FRACTION_WIDTH = "24" *) 
  (* C_A_TDATA_WIDTH = "32" *) 
  (* C_A_TUSER_WIDTH = "1" *) 
  (* C_A_WIDTH = "32" *) 
  (* C_BRAM_USAGE = "0" *) 
  (* C_B_FRACTION_WIDTH = "24" *) 
  (* C_B_TDATA_WIDTH = "32" *) 
  (* C_B_TUSER_WIDTH = "1" *) 
  (* C_B_WIDTH = "32" *) 
  (* C_COMPARE_OPERATION = "8" *) 
  (* C_C_FRACTION_WIDTH = "24" *) 
  (* C_C_TDATA_WIDTH = "32" *) 
  (* C_C_TUSER_WIDTH = "1" *) 
  (* C_C_WIDTH = "32" *) 
  (* C_FIXED_DATA_UNSIGNED = "0" *) 
  (* C_HAS_ABSOLUTE = "0" *) 
  (* C_HAS_ACCUMULATOR_A = "0" *) 
  (* C_HAS_ACCUMULATOR_S = "0" *) 
  (* C_HAS_ACCUM_INPUT_OVERFLOW = "0" *) 
  (* C_HAS_ACCUM_OVERFLOW = "0" *) 
  (* C_HAS_ACLKEN = "0" *) 
  (* C_HAS_ADD = "0" *) 
  (* C_HAS_ARESETN = "0" *) 
  (* C_HAS_A_TLAST = "0" *) 
  (* C_HAS_A_TUSER = "0" *) 
  (* C_HAS_B = "0" *) 
  (* C_HAS_B_TLAST = "0" *) 
  (* C_HAS_B_TUSER = "0" *) 
  (* C_HAS_C = "0" *) 
  (* C_HAS_COMPARE = "0" *) 
  (* C_HAS_C_TLAST = "0" *) 
  (* C_HAS_C_TUSER = "0" *) 
  (* C_HAS_DIVIDE = "0" *) 
  (* C_HAS_DIVIDE_BY_ZERO = "0" *) 
  (* C_HAS_EXPONENTIAL = "0" *) 
  (* C_HAS_FIX_TO_FLT = "0" *) 
  (* C_HAS_FLT_TO_FIX = "1" *) 
  (* C_HAS_FLT_TO_FLT = "0" *) 
  (* C_HAS_FMA = "0" *) 
  (* C_HAS_FMS = "0" *) 
  (* C_HAS_INVALID_OP = "0" *) 
  (* C_HAS_LOGARITHM = "0" *) 
  (* C_HAS_MULTIPLY = "0" *) 
  (* C_HAS_OPERATION = "0" *) 
  (* C_HAS_OPERATION_TLAST = "0" *) 
  (* C_HAS_OPERATION_TUSER = "0" *) 
  (* C_HAS_OVERFLOW = "0" *) 
  (* C_HAS_RECIP = "0" *) 
  (* C_HAS_RECIP_SQRT = "0" *) 
  (* C_HAS_RESULT_TLAST = "0" *) 
  (* C_HAS_RESULT_TUSER = "0" *) 
  (* C_HAS_SQRT = "0" *) 
  (* C_HAS_SUBTRACT = "0" *) 
  (* C_HAS_UNDERFLOW = "0" *) 
  (* C_LATENCY = "7" *) 
  (* C_MULT_USAGE = "0" *) 
  (* C_OPERATION_TDATA_WIDTH = "8" *) 
  (* C_OPERATION_TUSER_WIDTH = "1" *) 
  (* C_OPTIMIZATION = "1" *) 
  (* C_RATE = "1" *) 
  (* C_RESULT_FRACTION_WIDTH = "0" *) 
  (* C_RESULT_TDATA_WIDTH = "32" *) 
  (* C_RESULT_TUSER_WIDTH = "1" *) 
  (* C_RESULT_WIDTH = "32" *) 
  (* C_THROTTLE_SCHEME = "1" *) 
  (* C_TLAST_RESOLUTION = "0" *) 
  (* C_XDEVICEFAMILY = "artix7" *) 
  (* downgradeipidentifiedwarnings = "yes" *) 
  floating_point_0_floating_point_v7_1_7_viv i_synth
       (.aclk(aclk),
        .aclken(1'b0),
        .aresetn(1'b0),
        .m_axis_result_tdata(m_axis_result_tdata),
        .m_axis_result_tlast(NLW_i_synth_m_axis_result_tlast_UNCONNECTED),
        .m_axis_result_tready(m_axis_result_tready),
        .m_axis_result_tuser(NLW_i_synth_m_axis_result_tuser_UNCONNECTED[0]),
        .m_axis_result_tvalid(m_axis_result_tvalid),
        .s_axis_a_tdata(s_axis_a_tdata),
        .s_axis_a_tlast(1'b0),
        .s_axis_a_tready(s_axis_a_tready),
        .s_axis_a_tuser(1'b0),
        .s_axis_a_tvalid(s_axis_a_tvalid),
        .s_axis_b_tdata({1'b0,1'b0,1'b0,1'b0,1'b0,1'b0,1'b0,1'b0,1'b0,1'b0,1'b0,1'b0,1'b0,1'b0,1'b0,1'b0,1'b0,1'b0,1'b0,1'b0,1'b0,1'b0,1'b0,1'b0,1'b0,1'b0,1'b0,1'b0,1'b0,1'b0,1'b0,1'b0}),
        .s_axis_b_tlast(1'b0),
        .s_axis_b_tready(NLW_i_synth_s_axis_b_tready_UNCONNECTED),
        .s_axis_b_tuser(1'b0),
        .s_axis_b_tvalid(1'b0),
        .s_axis_c_tdata({1'b0,1'b0,1'b0,1'b0,1'b0,1'b0,1'b0,1'b0,1'b0,1'b0,1'b0,1'b0,1'b0,1'b0,1'b0,1'b0,1'b0,1'b0,1'b0,1'b0,1'b0,1'b0,1'b0,1'b0,1'b0,1'b0,1'b0,1'b0,1'b0,1'b0,1'b0,1'b0}),
        .s_axis_c_tlast(1'b0),
        .s_axis_c_tready(NLW_i_synth_s_axis_c_tready_UNCONNECTED),
        .s_axis_c_tuser(1'b0),
        .s_axis_c_tvalid(1'b0),
        .s_axis_operation_tdata({1'b0,1'b0,1'b0,1'b0,1'b0,1'b0,1'b0,1'b0}),
        .s_axis_operation_tlast(1'b0),
        .s_axis_operation_tready(NLW_i_synth_s_axis_operation_tready_UNCONNECTED),
        .s_axis_operation_tuser(1'b0),
        .s_axis_operation_tvalid(1'b0));
endmodule
`pragma protect begin_protected
`pragma protect version = 1
`pragma protect encrypt_agent = "XILINX"
`pragma protect encrypt_agent_info = "Xilinx Encryption Tool 2015"
`pragma protect key_keyowner="Cadence Design Systems.", key_keyname="cds_rsa_key", key_method="rsa"
`pragma protect encoding = (enctype="BASE64", line_length=76, bytes=64)
`pragma protect key_block
KMVw0FCOv34cWOupKA05LIFbQSQzhdC7cNx6tCC7Npkh6sezaILAhlbFmH18n8IdW398pPD6Glkh
nmMHOn6obA==

`pragma protect key_keyowner="Synopsys", key_keyname="SNPS-VCS-RSA-2", key_method="rsa"
`pragma protect encoding = (enctype="BASE64", line_length=76, bytes=128)
`pragma protect key_block
r2Vofo4ESYu6AQRP7OJMqj48QN1X+bTn4JEjmARwD+qhEKSRQmyGOUq1t8l0qg8qo/ZIs5VwKYwK
blMPD6vM/uEwnk5Wez0Hq/jPY0aEpB1pCERAX2X6smsXJzU2JpDb8Bv4jaiPQ9/mgDegydcxJcW4
WBwS5KXFO7Gsz3oKPK0=

`pragma protect key_keyowner="Aldec", key_keyname="ALDEC15_001", key_method="rsa"
`pragma protect encoding = (enctype="BASE64", line_length=76, bytes=256)
`pragma protect key_block
pAbtnX8wMTjyj7ktuU7kB3OsG4J3geGiLG/iiwFlNsW8S9qlZpamsi0d4sQtTqmPOjyAT23RYI03
3eJflbWyfGtfT0plGK6bngtMyTN/jf3W4syLadA6h7j9E8mOIobqiQmTamY9g0KJUU+ANrgjfOeN
szhoWM9qDRgcJaJU+Cx+nAY3VB4tTyv43oIrirLgR86OBanyXXakWvhEt54DbM0vCZ60t/V6QWMM
5AfcUu990jo+nQDtAof4C+iUq0lq5HXoPve30kHeLheDubNTRgn2Av6hPjPsQ5Qz0j2WAarM6KDn
7cHfTFTSgsr/E7X2uEKIN/4lJWHSxKUq7PDxUw==

`pragma protect key_keyowner="ATRENTA", key_keyname="ATR-SG-2015-RSA-3", key_method="rsa"
`pragma protect encoding = (enctype="BASE64", line_length=76, bytes=256)
`pragma protect key_block
rPYRq8HUEihuLW+Cu/YM2rG8TnDS0/Gq3OuS7DyesuYUbl7NRmqXiLHKzc9+77PQjmWHaU9ZJY3w
N6YcIOiMSkWEQLpbLg/pbpfex+DdzHHsSFs08kLH0Aeoi6wEMuwmutXxMSWf8pv2siWUaPA+NGwt
ziAvFi/n69rNrniM8mNc01TDuU6TvFPBierNczf7TfHf/MJ0sVVYEoNF80pmcX5wvnwy8yXBKI0h
aARNqp8ky5v7QanJDB0j6CtBvpVG6YZ2Cm249wygZ8h9+3OgBMbaZZew8UY3M34veYOSjAxxnJQw
/3/KId/WU24TWBYnFoEwhShGNnpuhsluwktCvA==

`pragma protect key_keyowner="Xilinx", key_keyname="xilinxt_2017_05", key_method="rsa"
`pragma protect encoding = (enctype="BASE64", line_length=76, bytes=256)
`pragma protect key_block
H+vRkXrzIAXQKMevF01F0iWGRI6js2UlE0nDAE6dXjzlLvq3M3TgTAh1S5uwJFclzk5LaWErpkdd
bbGl6vqhScAbxp8N6yS+iKPZmIQgQybWc2aK6E5OT0qBcrXeLI9rd8c/FZH1E3d1/n4Ejgqjikka
Zri/Blr7vecUvt9ENOfmv8I2IwEibXrh+G+e6zXmAsiml/ciKeDtM4i+Ep7eUoVnlGB/uOC8buAq
eddIDAHqIu49VqNwin/vaacuHNEK0yjtupoIsxB8Fq4F8Wxk1tYNf80IQzD3C54Iz+D1ZmCe9IHQ
FU9XI2HrbdiAqeZMEgaa1bJs210sN9JTZGjtFw==

`pragma protect key_keyowner="Mentor Graphics Corporation", key_keyname="MGC-VELOCE-RSA", key_method="rsa"
`pragma protect encoding = (enctype="BASE64", line_length=76, bytes=128)
`pragma protect key_block
j2xQg2iDFbFFI7+dDRrAxN59y4jd3S1Zvtd25yqSjv9nr/Fw2RraTH8/F2fUIIHYeeg2Wby5LkJ2
CgWtYUuRfFFrqGhr7jf8OGrKjgf2FYM2Xn6Ltu9TuJNNkSLA2uR1ibWyQm3uIN98tYI9tyOskioh
MJOMCB7MiE3RwcNOta0=

`pragma protect key_keyowner="Mentor Graphics Corporation", key_keyname="MGC-VERIF-SIM-RSA-2", key_method="rsa"
`pragma protect encoding = (enctype="BASE64", line_length=76, bytes=256)
`pragma protect key_block
XpqrVh5QI3WGWXCuXjnC9FYqu4ZL7+4Kk3kZlGgM/OdNMMdHTEE+gPHVGUx3Rt2e3mpY35HZ2V9r
iPS63FtPGbct+LA3iXsM8a26Sz1cR3DkQE/0Y7FY6mH9bqFXfJtntPHOz5eKls4LZH/lsg+59CjB
+WIVFVBGt455y8OplHxSSGYHCaWt0qT8zehnOZIx8jz3rxqduAMXu00jSfT3adACc+zTodb96KUD
xqOE3iNnyc0nU2JtLHvtKOuVLitKfLKEzKarbNEZ6kLp3bHG4da6dXCzxwe1GJ+OnfQYqkgJSU/b
hUOKvViAdP+Zre00Dm6xQdH/XIUwmpbDM9wlFw==

`pragma protect key_keyowner="Mentor Graphics Corporation", key_keyname="MGC-PREC-RSA", key_method="rsa"
`pragma protect encoding = (enctype="BASE64", line_length=76, bytes=256)
`pragma protect key_block
O9X3+A2LSkjC5nbZ9V6tRMCJjus0Ch63DA5jC/FXLcMAcmrWrabMk2+0prSkUGt1ezSmTckNo49H
AeCO3DJzLWx7o2jyYGGlmxp6Crwj3AiIJ6M+FV8qETaWS/cigC5BSJT6Zwa2ZtcMCOGjNBU1EQup
/9KxswywE8OKEF+Lqw+qFHx/XpGF7lPw+XBcRbEY04QsLXhKR2JeJv7g3ktjwEjiMIfQaORulBjk
x4o11R8LUie/RVMZ31BjiH/D0IXdXK5/3ue5QiSgT02HTTFZ7r4T3kOpO3D6veo2F9PBKjCw8NPo
e4W17AhmWeT41lXWEHBQoveqAjY8u4GwKdxC/Q==

`pragma protect key_keyowner="Synplicity", key_keyname="SYNP15_1", key_method="rsa"
`pragma protect encoding = (enctype="BASE64", line_length=76, bytes=256)
`pragma protect key_block
A0xyok0FD7BRKhm4Cd5wYCX4UyGFj5YkcD/1gHQOyvIu7Cxe6BivsDOqp8lgiYNQ2OniQDSNEn6W
CNAVzxlyVbevXTOYY8CZlB3r5CgQRXagbTbIPAoYnFFdfKsEN3rgJ3u8FI2nm559WGs836luGzGH
S0qicQWUHBkHST9c/vBW5DmbC2RsMIXUWKdjimHkmYQF0s+yAELT2onmt6rGbZ8zydJqspMThOs8
dISN+ZqhTfcDGwjIpz3jSn/lKqYnKbJFyCYl6Pa5oQ2RBXTd6+0E2vk4npVhMCOM2NyQy4WOwL7W
3snfaFp5jStsCUEphT/S8YxD+3bqHp1XwB4cpg==

`pragma protect data_method = "AES128-CBC"
`pragma protect encoding = (enctype = "BASE64", line_length = 76, bytes = 252048)
`pragma protect data_block
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
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
