rFeijoo/FPGA_PID/PC4/6 - vivado/Interface_Arduino_Basys3.srcs/sources_1/ip/floating_point_0/floating_point_0_sim_netlist.vhdl

-- Copyright 1986-2018 Xilinx, Inc. All Rights Reserved.
-- --------------------------------------------------------------------------------
-- Tool Version: Vivado v.2018.3 (win64) Build 2405991 Thu Dec  6 23:38:27 MST 2018
-- Date        : Tue Dec 15 04:11:41 2020
-- Host        : RAFAELFEIJL2C3E running 64-bit major release  (build 9200)
-- Command     : write_vhdl -force -mode funcsim
--               c:/Mac/Home/Documents/Windows/Vivado/Projects/Interface_Arduino_Basys3/Interface_Arduino_Basys3.srcs/sources_1/ip/floating_point_0/floating_point_0_sim_netlist.vhdl
-- Design      : floating_point_0
-- Purpose     : This VHDL netlist is a functional simulation representation of the design and should not be modified or
--               synthesized. This netlist cannot be used for SDF annotated simulation.
-- Device      : xc7a35tcpg236-1
-- --------------------------------------------------------------------------------
`protect begin_protected
`protect version = 1
`protect encrypt_agent = "XILINX"
`protect encrypt_agent_info = "Xilinx Encryption Tool 2015"
`protect key_keyowner="Cadence Design Systems.", key_keyname="cds_rsa_key", key_method="rsa"
`protect encoding = (enctype="BASE64", line_length=76, bytes=64)
`protect key_block
KMVw0FCOv34cWOupKA05LIFbQSQzhdC7cNx6tCC7Npkh6sezaILAhlbFmH18n8IdW398pPD6Glkh
nmMHOn6obA==

`protect key_keyowner="Synopsys", key_keyname="SNPS-VCS-RSA-2", key_method="rsa"
`protect encoding = (enctype="BASE64", line_length=76, bytes=128)
`protect key_block
r2Vofo4ESYu6AQRP7OJMqj48QN1X+bTn4JEjmARwD+qhEKSRQmyGOUq1t8l0qg8qo/ZIs5VwKYwK
blMPD6vM/uEwnk5Wez0Hq/jPY0aEpB1pCERAX2X6smsXJzU2JpDb8Bv4jaiPQ9/mgDegydcxJcW4
WBwS5KXFO7Gsz3oKPK0=

`protect key_keyowner="Aldec", key_keyname="ALDEC15_001", key_method="rsa"
`protect encoding = (enctype="BASE64", line_length=76, bytes=256)
`protect key_block
pAbtnX8wMTjyj7ktuU7kB3OsG4J3geGiLG/iiwFlNsW8S9qlZpamsi0d4sQtTqmPOjyAT23RYI03
3eJflbWyfGtfT0plGK6bngtMyTN/jf3W4syLadA6h7j9E8mOIobqiQmTamY9g0KJUU+ANrgjfOeN
szhoWM9qDRgcJaJU+Cx+nAY3VB4tTyv43oIrirLgR86OBanyXXakWvhEt54DbM0vCZ60t/V6QWMM
5AfcUu990jo+nQDtAof4C+iUq0lq5HXoPve30kHeLheDubNTRgn2Av6hPjPsQ5Qz0j2WAarM6KDn
7cHfTFTSgsr/E7X2uEKIN/4lJWHSxKUq7PDxUw==

`protect key_keyowner="ATRENTA", key_keyname="ATR-SG-2015-RSA-3", key_method="rsa"
`protect encoding = (enctype="BASE64", line_length=76, bytes=256)
`protect key_block
rPYRq8HUEihuLW+Cu/YM2rG8TnDS0/Gq3OuS7DyesuYUbl7NRmqXiLHKzc9+77PQjmWHaU9ZJY3w
N6YcIOiMSkWEQLpbLg/pbpfex+DdzHHsSFs08kLH0Aeoi6wEMuwmutXxMSWf8pv2siWUaPA+NGwt
ziAvFi/n69rNrniM8mNc01TDuU6TvFPBierNczf7TfHf/MJ0sVVYEoNF80pmcX5wvnwy8yXBKI0h
aARNqp8ky5v7QanJDB0j6CtBvpVG6YZ2Cm249wygZ8h9+3OgBMbaZZew8UY3M34veYOSjAxxnJQw
/3/KId/WU24TWBYnFoEwhShGNnpuhsluwktCvA==

`protect key_keyowner="Xilinx", key_keyname="xilinxt_2017_05", key_method="rsa"
`protect encoding = (enctype="BASE64", line_length=76, bytes=256)
`protect key_block
H+vRkXrzIAXQKMevF01F0iWGRI6js2UlE0nDAE6dXjzlLvq3M3TgTAh1S5uwJFclzk5LaWErpkdd
bbGl6vqhScAbxp8N6yS+iKPZmIQgQybWc2aK6E5OT0qBcrXeLI9rd8c/FZH1E3d1/n4Ejgqjikka
Zri/Blr7vecUvt9ENOfmv8I2IwEibXrh+G+e6zXmAsiml/ciKeDtM4i+Ep7eUoVnlGB/uOC8buAq
eddIDAHqIu49VqNwin/vaacuHNEK0yjtupoIsxB8Fq4F8Wxk1tYNf80IQzD3C54Iz+D1ZmCe9IHQ
FU9XI2HrbdiAqeZMEgaa1bJs210sN9JTZGjtFw==

`protect key_keyowner="Mentor Graphics Corporation", key_keyname="MGC-VELOCE-RSA", key_method="rsa"
`protect encoding = (enctype="BASE64", line_length=76, bytes=128)
`protect key_block
j2xQg2iDFbFFI7+dDRrAxN59y4jd3S1Zvtd25yqSjv9nr/Fw2RraTH8/F2fUIIHYeeg2Wby5LkJ2
CgWtYUuRfFFrqGhr7jf8OGrKjgf2FYM2Xn6Ltu9TuJNNkSLA2uR1ibWyQm3uIN98tYI9tyOskioh
MJOMCB7MiE3RwcNOta0=

`protect key_keyowner="Mentor Graphics Corporation", key_keyname="MGC-VERIF-SIM-RSA-2", key_method="rsa"
`protect encoding = (enctype="BASE64", line_length=76, bytes=256)
`protect key_block
XpqrVh5QI3WGWXCuXjnC9FYqu4ZL7+4Kk3kZlGgM/OdNMMdHTEE+gPHVGUx3Rt2e3mpY35HZ2V9r
iPS63FtPGbct+LA3iXsM8a26Sz1cR3DkQE/0Y7FY6mH9bqFXfJtntPHOz5eKls4LZH/lsg+59CjB
+WIVFVBGt455y8OplHxSSGYHCaWt0qT8zehnOZIx8jz3rxqduAMXu00jSfT3adACc+zTodb96KUD
xqOE3iNnyc0nU2JtLHvtKOuVLitKfLKEzKarbNEZ6kLp3bHG4da6dXCzxwe1GJ+OnfQYqkgJSU/b
hUOKvViAdP+Zre00Dm6xQdH/XIUwmpbDM9wlFw==

`protect key_keyowner="Mentor Graphics Corporation", key_keyname="MGC-PREC-RSA", key_method="rsa"
`protect encoding = (enctype="BASE64", line_length=76, bytes=256)
`protect key_block
JeNXp/I2Y+2tZNVDVRsyfzux17BYzpBtI+9+K/ZFRHH7fLHQwf+A4kfSdR45fngoFObJQGQmEnOC
2q/WiDB4cZTOr4um96T26dHfWFAUaWCGWgNRXgSGf+mo/WUS1s5wJUfyKXCmnwg8W8FXOx4m9D6U
LjENLuZ/GncQpXQeSzIWy9Op5VmrrqScdZMdirTwtq8QUZ5PDlgN/Jbo/X/qxD9eUV9VWkGqJrLb
kG6lZjiN1psD8jU4LT6W8Ad8AcceAw8WKKoES4p8TCiOeJ1ncueSoa0X6DSs9Qy6m2jMmhREPOKM
LZ1kGTKcRl3VfBw+ZUlgK1MdslaU2EY6KvK5kA==

`protect key_keyowner="Synplicity", key_keyname="SYNP15_1", key_method="rsa"
`protect encoding = (enctype="BASE64", line_length=76, bytes=256)
`protect key_block
tkMK6tYB8zFcf1Zm2I7WShDYc+tmuZ1NBeY1mUH7c2hmsa2V2RDruyoqEo3XD01BIZQlQuGnoqGT
XtFm29nMdvUbY5YuWXnfYPdgzb+/0/vAIEsMyrWjQesUvNlump3u3I19VkOPo1y3Orzvnpez88w6
C73fvOjDKZ94eKunSz4g/abjEPJSYmT714q9Ir/dn1b5LppTuyPTA1hl/NB+ORdkb3v330M2rdcZ
zwvSiaqI3JOQYAdy1zlSkTXYO84sGu/831gCYMlJAWt/A2KahKygITKTwdjYh6CgX6wygL4OZ/Ac
b592eeCul4uKQq+0qwpP1DwxKy09XsSW0kFdkw==

`protect data_method = "AES128-CBC"
`protect encoding = (enctype = "BASE64", line_length = 76, bytes = 315648)
`protect data_block
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
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
